aarya-tanwade/bone-buds/docs/README.md

# OSSIS / Documentation

Our engineering records for OSSIS, the first BoneBuds prototype.

| Document | Purpose |
| --- | --- |
| [Test setup](test-setup.md) | Shared bench wiring and firmware entry points |
| [Test results](test-results.md) | Passed tests and the latest playback check |
| [Development log](development-log.md) | Dated progress, earlier issues and changes |
| [Firmware guide](../code/README.md) | Build, upload and test instructions |

We have verified Bluetooth playback and wireless OTA. Our latest phone test uses two BCTs in parallel on one amplifier, with clear, loud audio. Independent stereo is next; CAD work continues in parallel.

The [root README](../README.md) gives the full project overview. Early baseline records used the name Alpha 0.1; we now call the prototype OSSIS. Older PNG diagrams under `images/diagrams/` remain historical references; our current wiring table and firmware guides describe the working setup.
