aarya-tanwade/bone-buds/images/README.md

# Images

Add prototype photos, wiring pictures, circuit diagrams, and test plots here as they become available.

Use descriptive filenames (for example, `prototype1-wiring.jpg`). The repository does not contain a verified wiring photograph yet.
