aarya-tanwade/bone-buds/hardware/compact_v2/exports/contact_detail.png

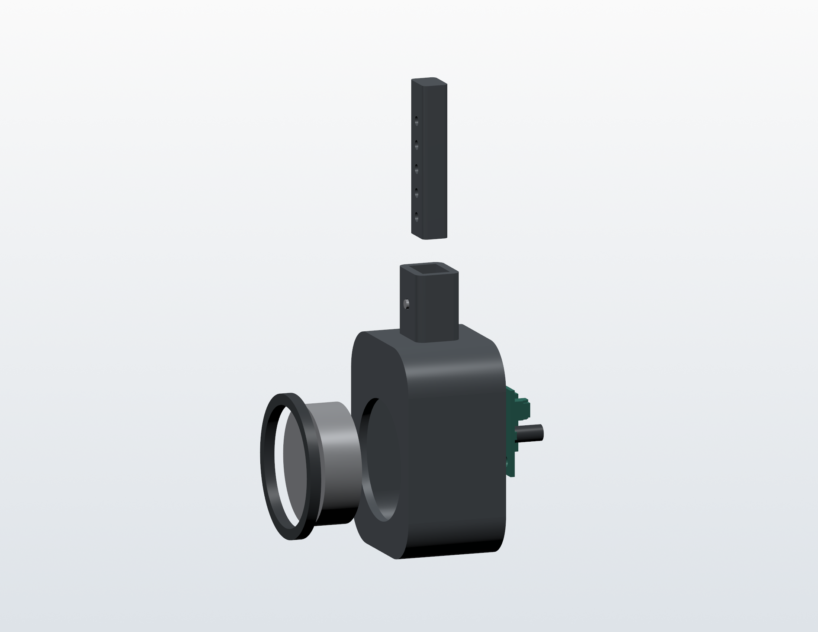
hardware/compact_v2/exports/contact_detail.png
