aarya-tanwade/bone-buds/hardware/compact_v2/exports/electronics.png

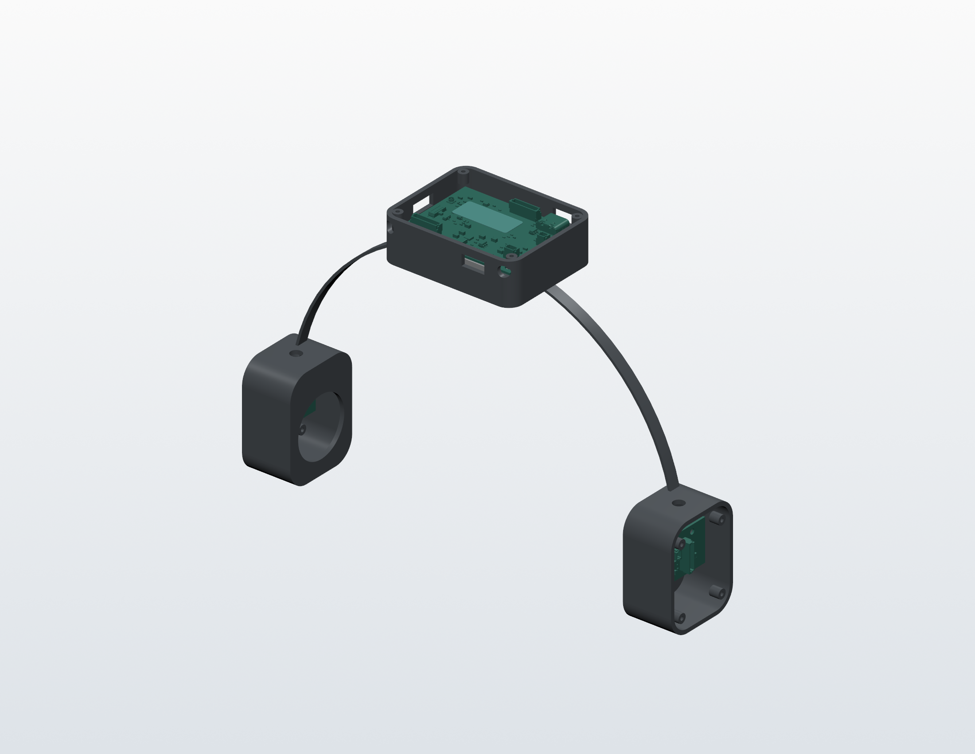
hardware/compact_v2/exports/electronics.png
