aarya-tanwade/bone-buds/hardware/compact_v2/exports/exploded.png

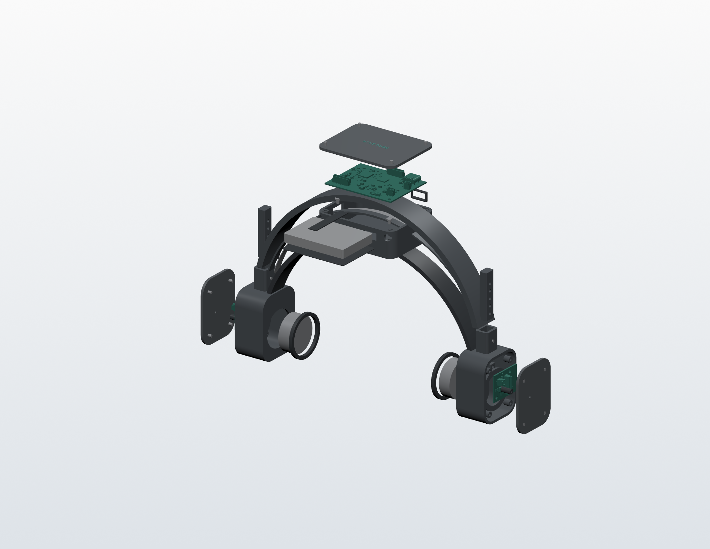
hardware/compact_v2/exports/exploded.png
