aarya-tanwade/bone-buds/hardware/compact_v2/exports/front.png

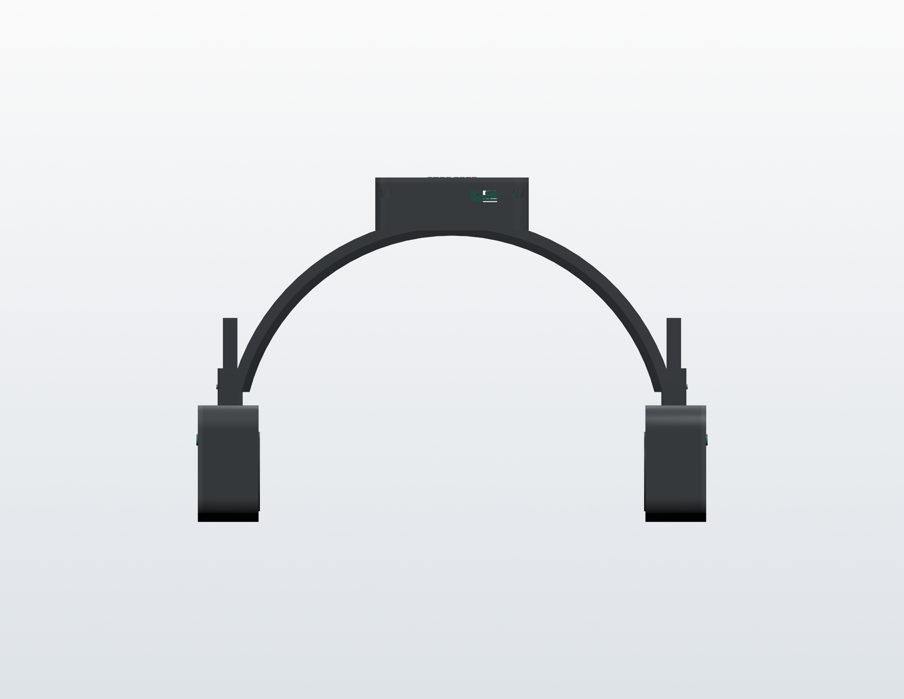
hardware/compact_v2/exports/front.png
