aarya-tanwade/bone-buds/hardware/compact_v2/exports/hero.png

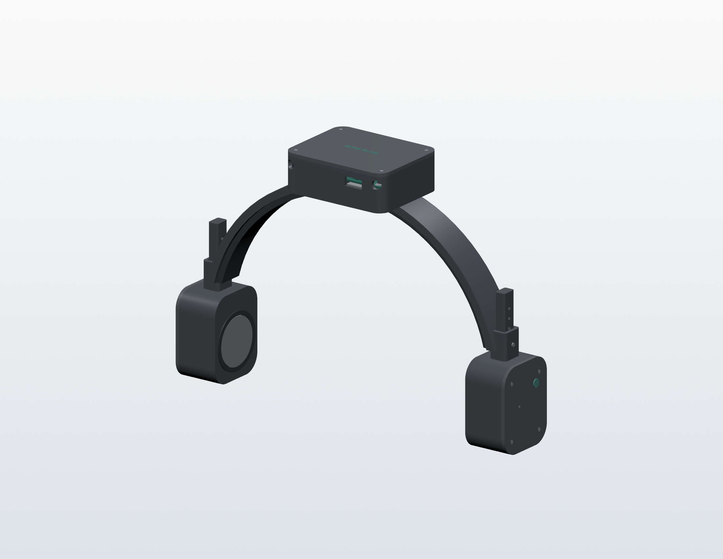
hardware/compact_v2/exports/hero.png
