aarya-tanwade/bone-buds/hardware/compact_v2/exports/side.png

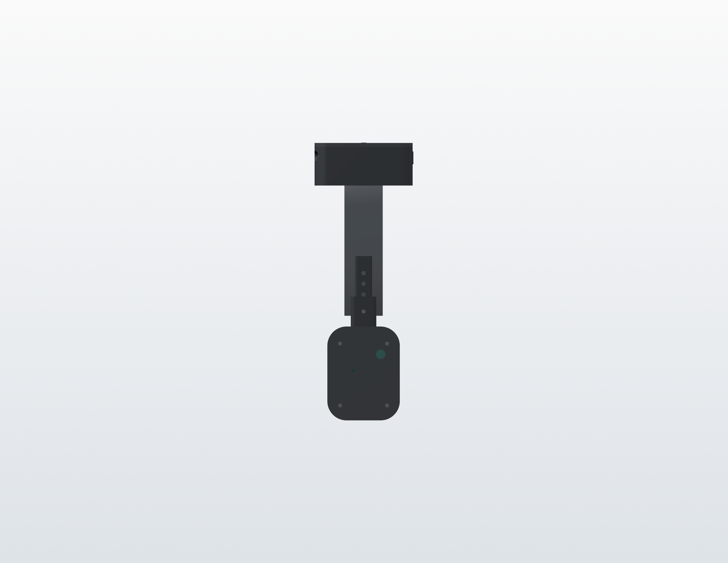
hardware/compact_v2/exports/side.png
