aarya-tanwade/bone-buds/hardware/compact_v2/exports/top.png

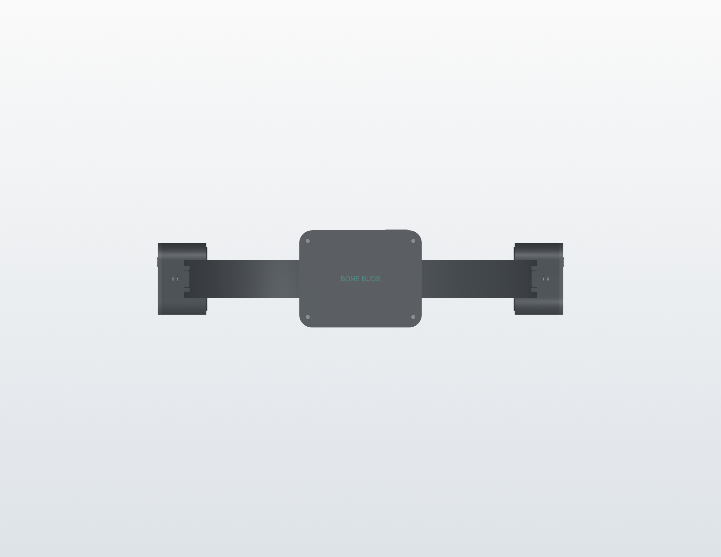
hardware/compact_v2/exports/top.png
