aarya-tanwade/bone-buds/hardware/compact_v2/sources/mic_drawing.png

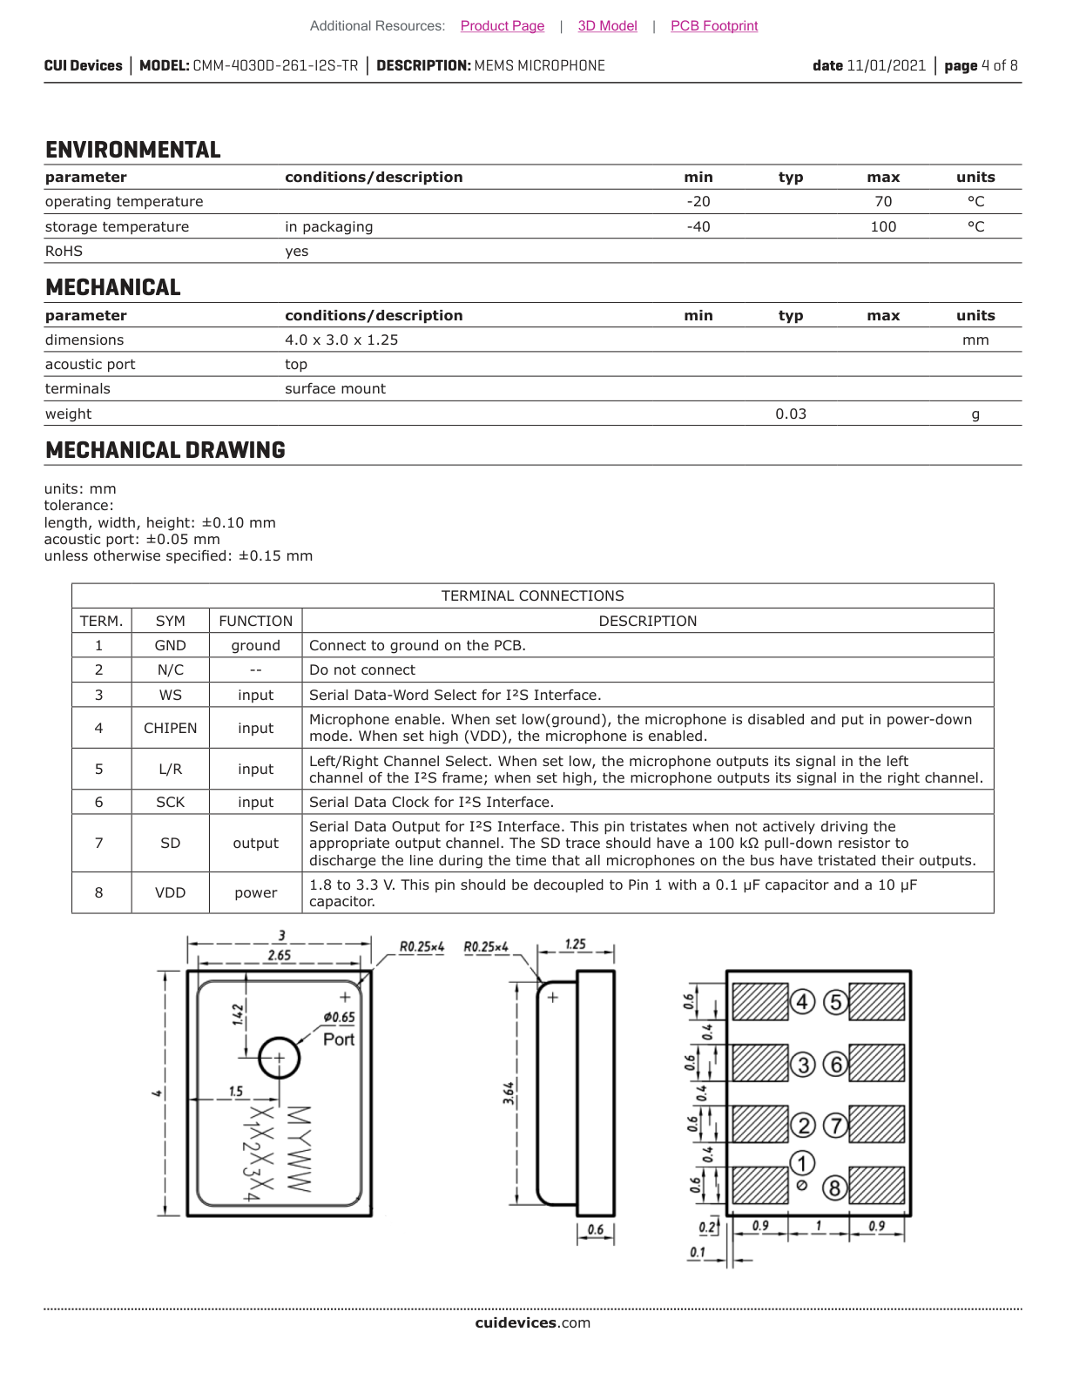
hardware/compact_v2/sources/mic_drawing.png
