aarya-tanwade/bone-buds/images/diagrams/current-audio-signal-flow.png

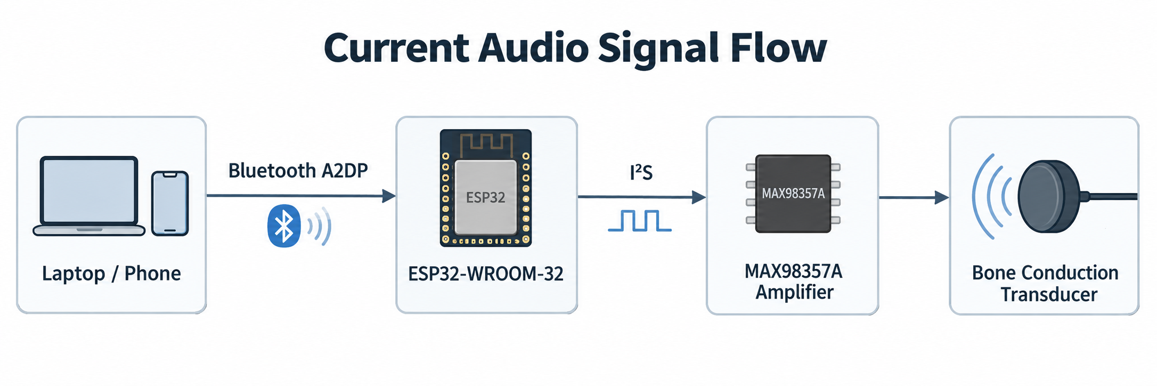
images/diagrams/current-audio-signal-flow.png
