aarya-tanwade/bone-buds/images/diagrams/development-progress.png

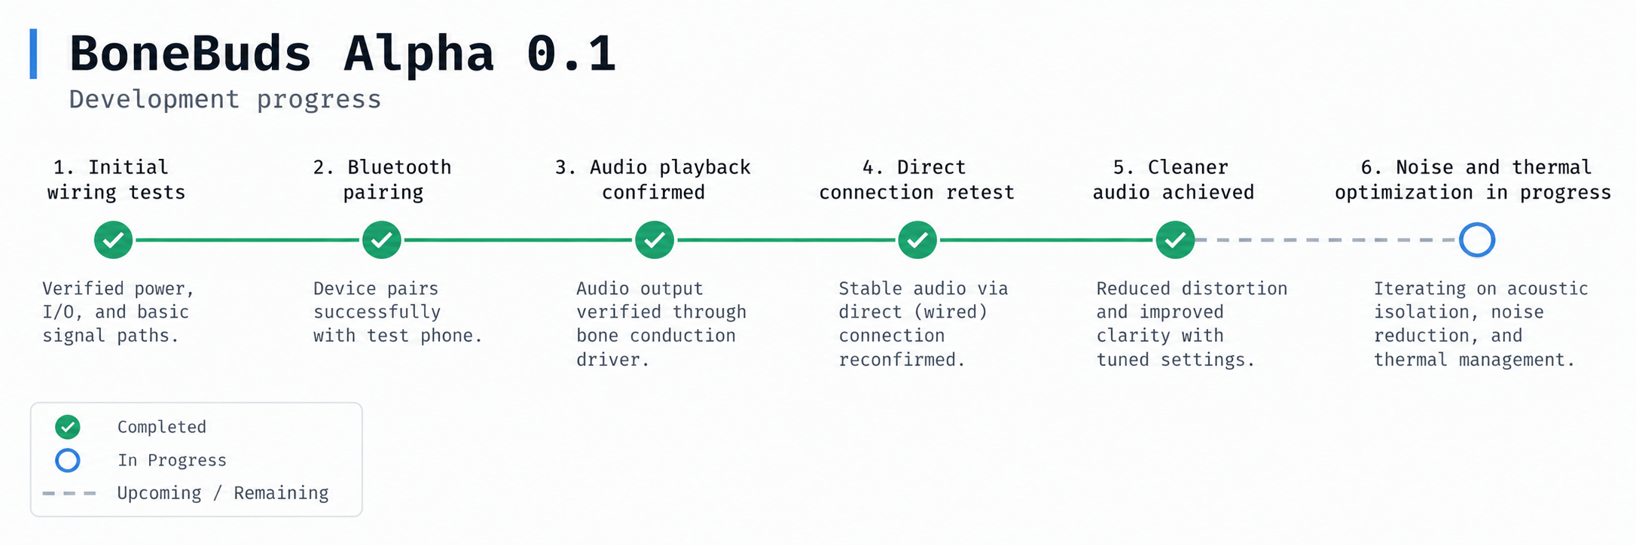
images/diagrams/development-progress.png
