aarya-tanwade/bone-buds/images/diagrams/ossis-stereo-audio-path.png

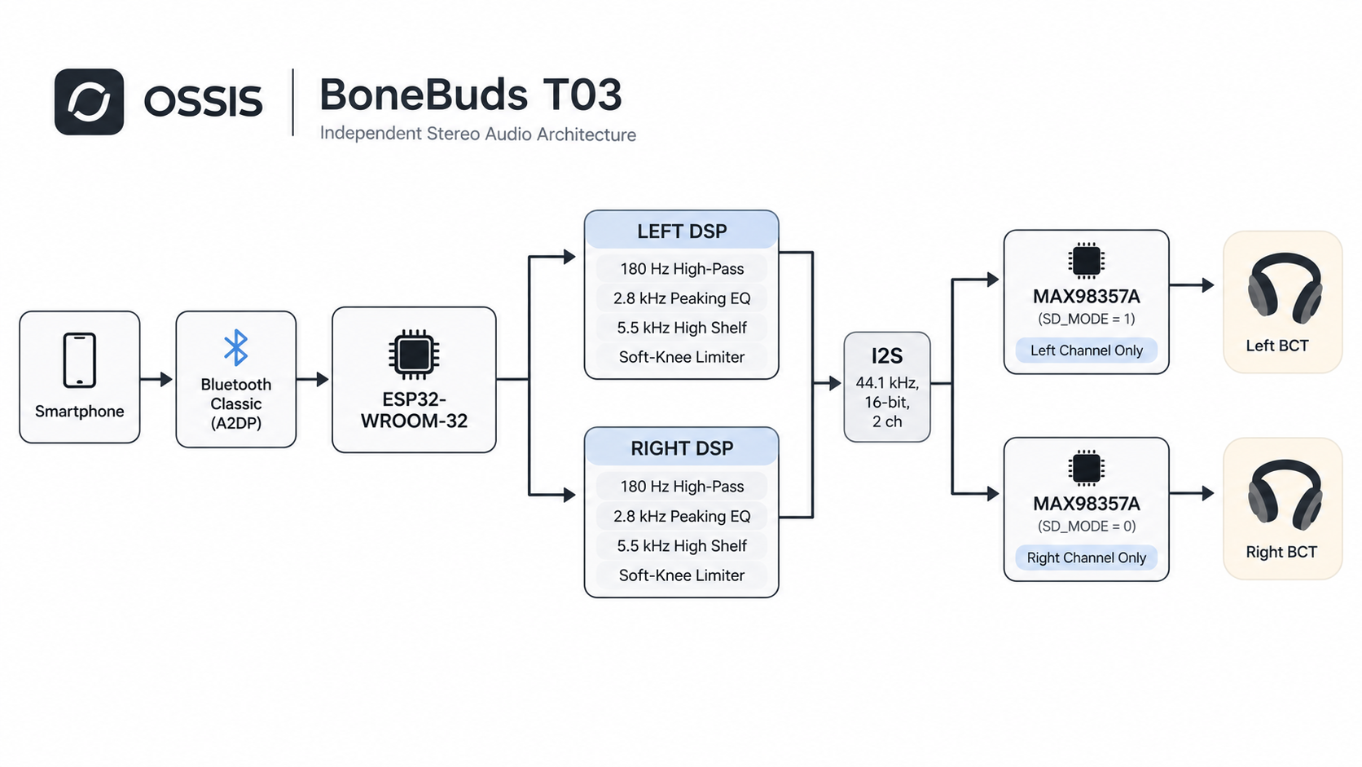
images/diagrams/ossis-stereo-audio-path.png
