aarya-tanwade/bone-buds/images/diagrams/t02-wireless-update.png

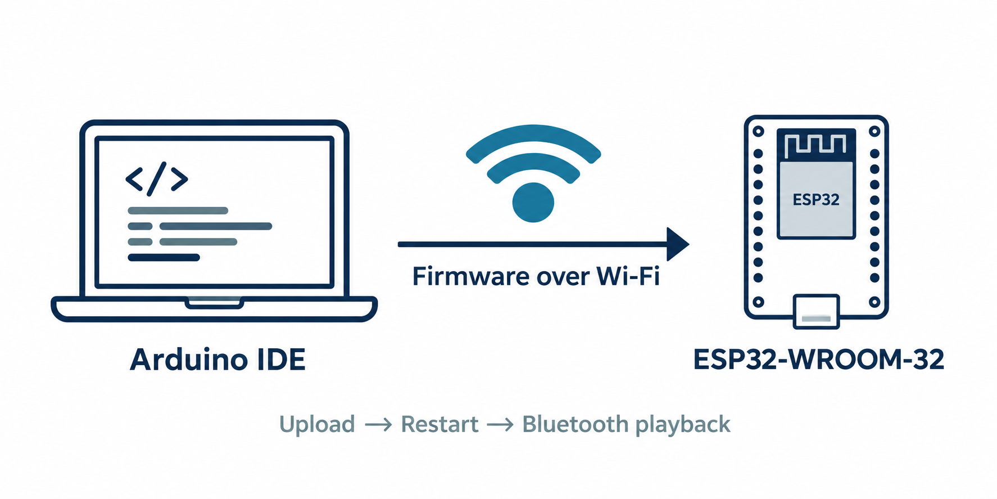
images/diagrams/t02-wireless-update.png
