aarya-tanwade/bone-buds/images/hero/bonebuds-alpha-0.1.png

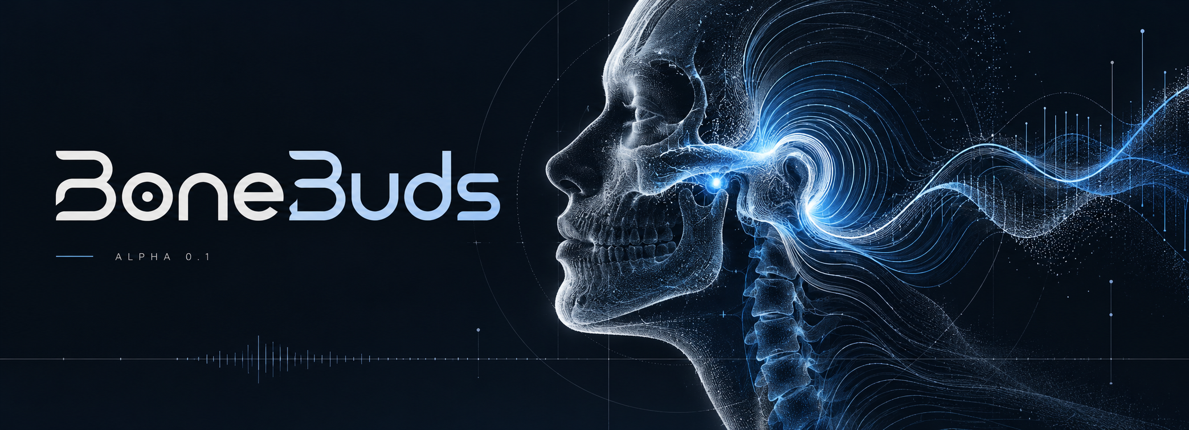
images/hero/bonebuds-alpha-0.1.png
