aarya-tanwade/bone-buds/hardware/compact_v2/mechanical/step/bone_buds_revb_assembly.step

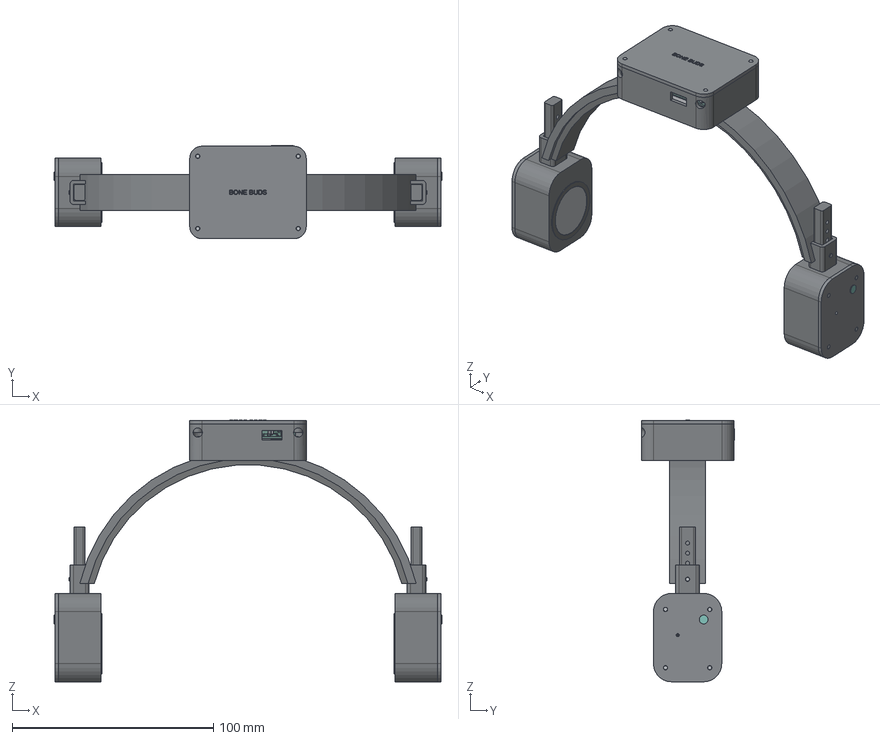
[picture p19: CAD file, 2026-10-23]
hardware/compact_v2/mechanical/step/bone_buds_revb_assembly.step
193.0 x 46.4 x 130.2 mm
01_PA12_headband_cable_channel
02_spring_strip_0p5mm
03_TPU_crown_cushion
04_hidden_loom_envelope
M2_PCB_screw_H1
M2_PCB_screw_H2
M2_lid_screw_-25_-18
M2_lid_screw_25_-18
M2_lid_screw_-25_18
M2_lid_screw_25_18
05_PA12_controller_lower_shell
06_PA12_controller_service_lid
07_ACTUAL_KICAD_CONTROLLER
08_PROTECTED_1S_500mAh_PACK_ENVELOPE
09_TPU_battery_cradle
10_TPU_battery_retaining_strap
11_recessed_brand_mark
12_FPC_ANTENNA_ENVELOPE
13_USB_port_TPU_bezel
right_M2_service_screw_-11_-22
right_M2_service_screw_11_-22
right_M2_service_screw_-11_7
right_M2_service_screw_11_7
right_PA12_pod_shell
right_PA12_service_lid
right_ACTUAL_KICAD_AUDIO
right_TRANSDUCER_25x8_ENVELOPE
right_PA12_rigid_transducer_retainer
right_TPU_skin_contact_surround
right_TPU_mic_acoustic_duct
right_TPU_cable_strain_relief
right_PA12_adjustment_rail
right_PA12_slide_collar
right_M2_fit_clamp
right_TPU_tactile_LR_marker
left_M2_service_screw_-11_-22
left_M2_service_screw_11_-22
left_M2_service_screw_-11_7
left_M2_service_screw_11_7
left_PA12_pod_shell
left_PA12_service_lid
left_ACTUAL_KICAD_AUDIO
left_TRANSDUCER_25x8_ENVELOPE
left_PA12_rigid_transducer_retainer
left_TPU_skin_contact_surround
left_TPU_mic_acoustic_duct
left_TPU_cable_strain_relief
left_PA12_adjustment_rail
left_PA12_slide_collar
left_M2_fit_clamp
left_TPU_tactile_LR_marker
