aarya-tanwade/bone-buds/hardware/compact_v2/mechanical/step/left_PA12_slide_collar.step

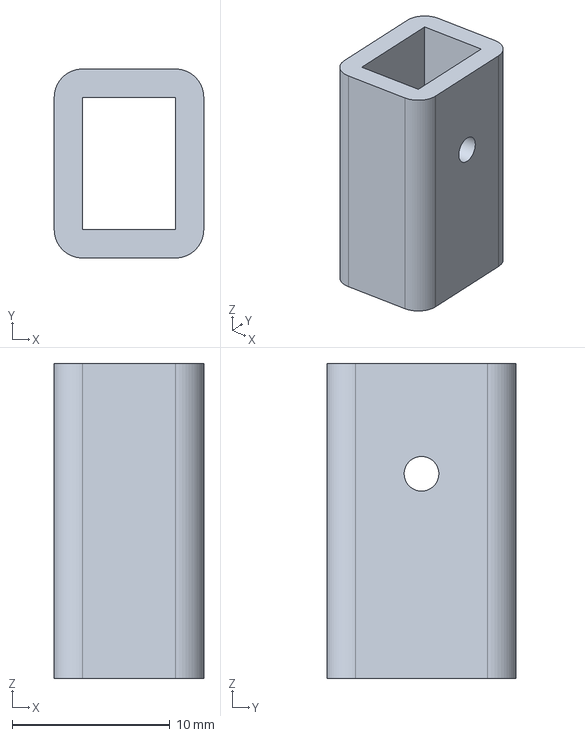
[picture p20: CAD file, 2026-10-23]
hardware/compact_v2/mechanical/step/left_PA12_slide_collar.step
9.50 x 12.0 x 20.0 mm
