aarya-tanwade/bone-buds/hardware/compact_v2/mechanical/step/left_PA12_rigid_transducer_retainer.step

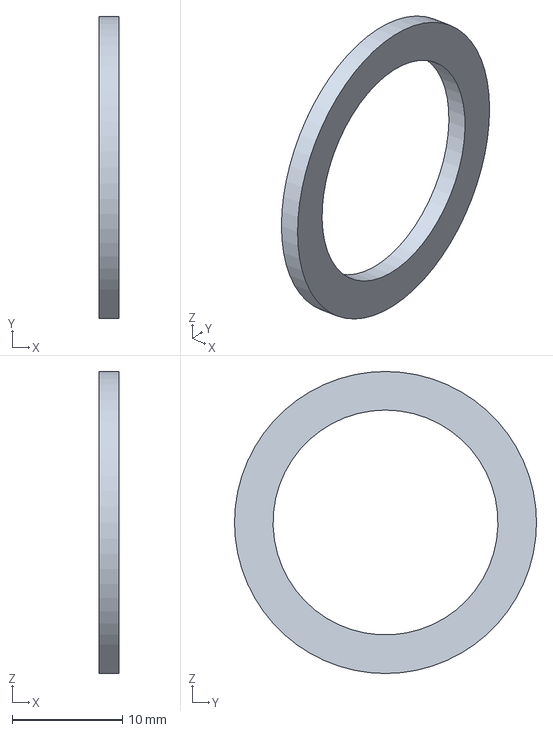
[picture p21: CAD file, 2026-10-23]
hardware/compact_v2/mechanical/step/left_PA12_rigid_transducer_retainer.step
1.80 x 27.4 x 27.4 mm
