aarya-tanwade/bone-buds/hardware/compact_v2/pcb/models/CMM4030.step

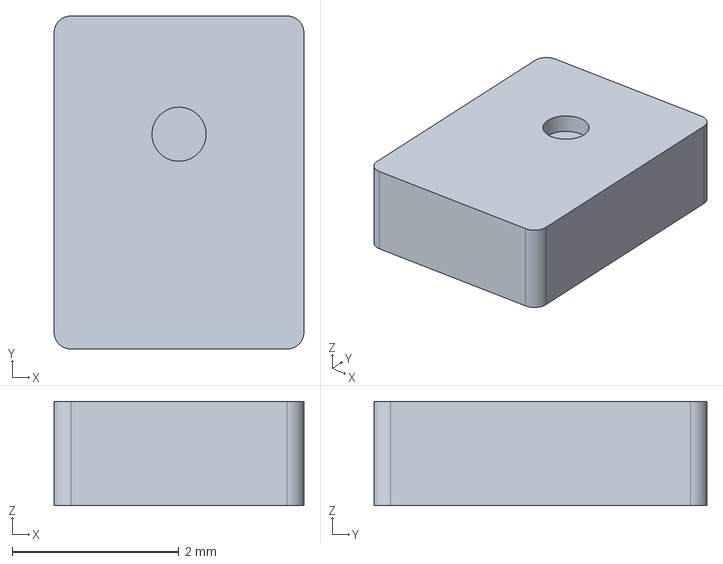
[picture p22: CAD file, 2026-10-23]
hardware/compact_v2/pcb/models/CMM4030.step
3.00 x 4.00 x 1.25 mm
