aarya-tanwade/bone-buds/hardware/compact_v2/mechanical/step/06_PA12_controller_service_lid.step

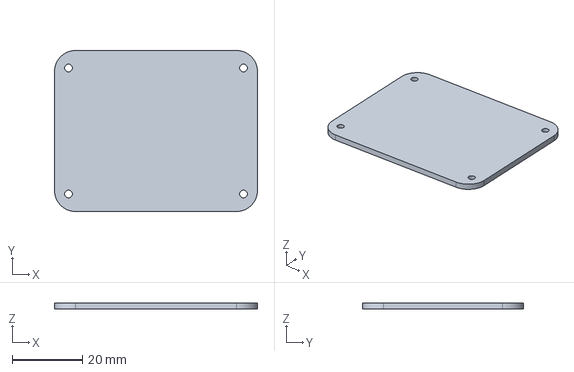
[picture p23: CAD file, 2026-10-23]
hardware/compact_v2/mechanical/step/06_PA12_controller_service_lid.step
58.0 x 46.0 x 1.80 mm
