aarya-tanwade/bone-buds/hardware/compact_v2/mechanical/step/05_PA12_controller_lower_shell.step

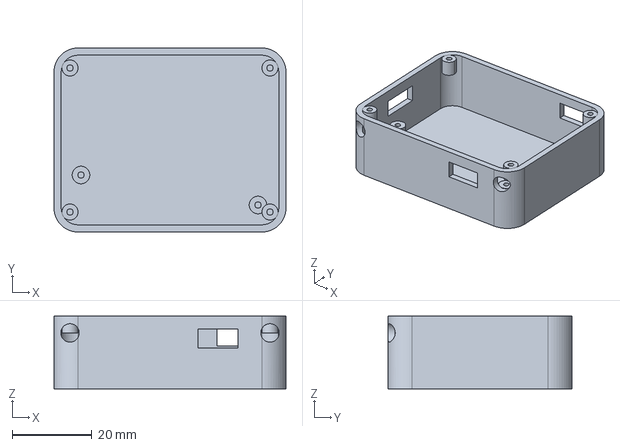
[picture p24: CAD file, 2026-10-23]
hardware/compact_v2/mechanical/step/05_PA12_controller_lower_shell.step
58.0 x 46.0 x 18.2 mm
