aarya-tanwade/bone-buds/hardware/compact_v2/mechanical/step/left_TPU_mic_acoustic_duct.step

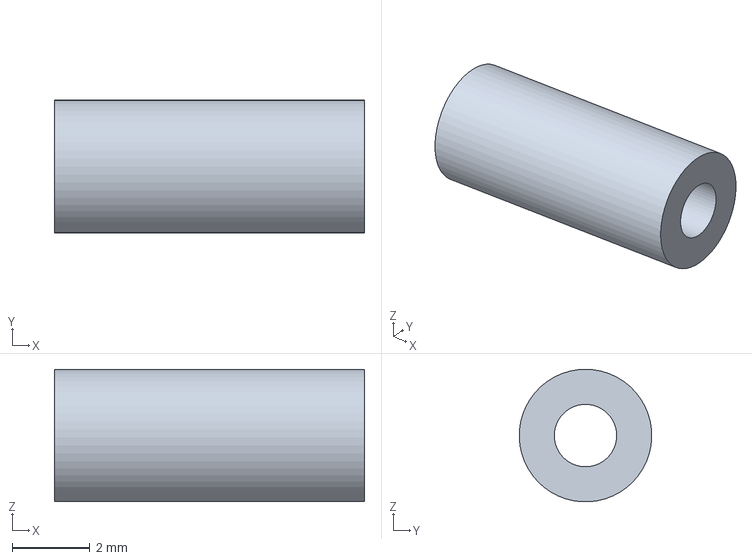
[picture p25: CAD file, 2026-10-23]
hardware/compact_v2/mechanical/step/left_TPU_mic_acoustic_duct.step
7.95 x 3.40 x 3.40 mm
