aarya-tanwade/bone-buds/hardware/compact_v2/mechanical/step/01_PA12_headband_cable_channel.step

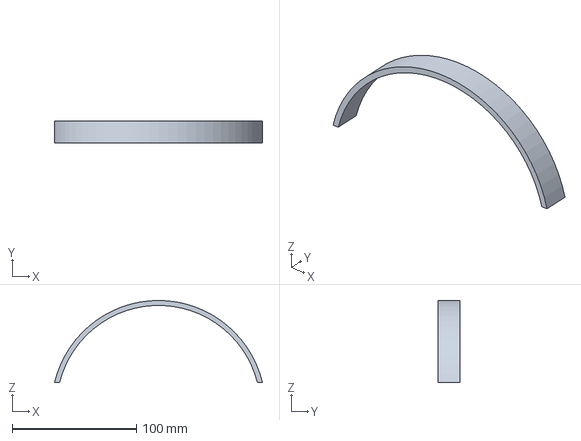
[picture p26: CAD file, 2026-10-23]
hardware/compact_v2/mechanical/step/01_PA12_headband_cable_channel.step
167.3 x 18.0 x 66.0 mm
