aarya-tanwade/bone-buds/hardware/compact_v2/mechanical/step/left_PA12_pod_shell.step

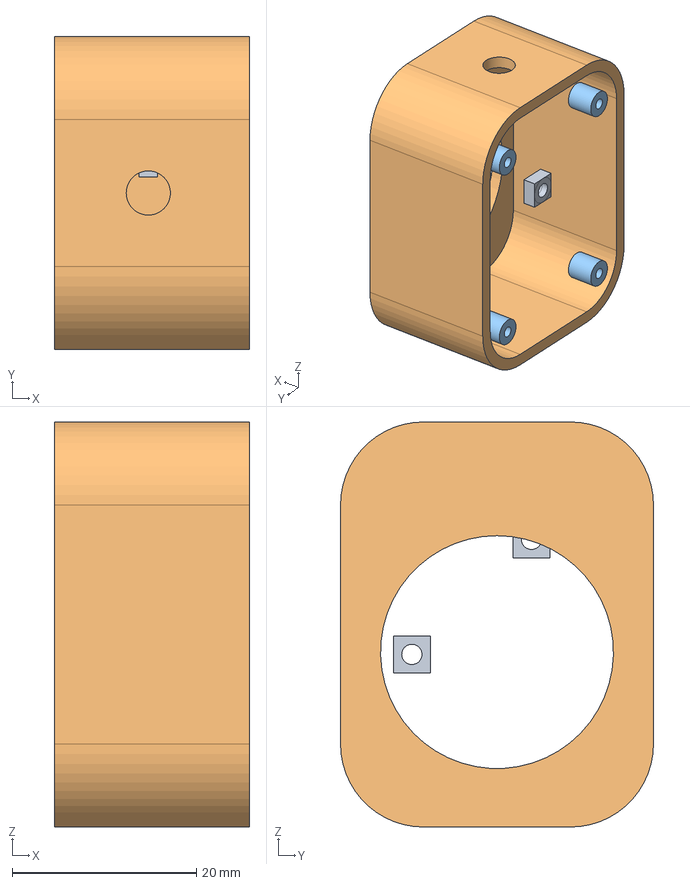
[picture p27: CAD file, 2026-10-23]
hardware/compact_v2/mechanical/step/left_PA12_pod_shell.step
21.2 x 34.0 x 44.0 mm
