aarya-tanwade/bone-buds/hardware/compact_v2/mechanical/step/09_TPU_battery_cradle.step

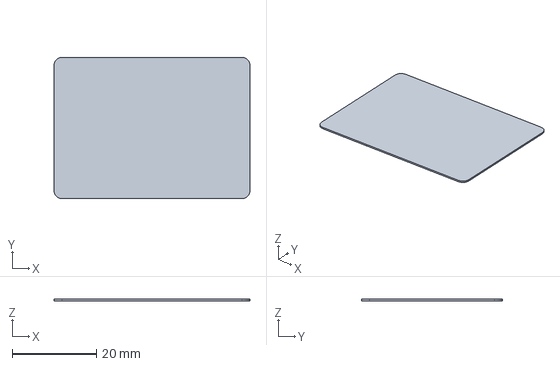
[picture p28: CAD file, 2026-10-23]
hardware/compact_v2/mechanical/step/09_TPU_battery_cradle.step
46.6 x 33.6 x 0.4 mm
