aarya-tanwade/bone-buds/hardware/compact_v2/mechanical/step/right_TPU_cable_strain_relief.step

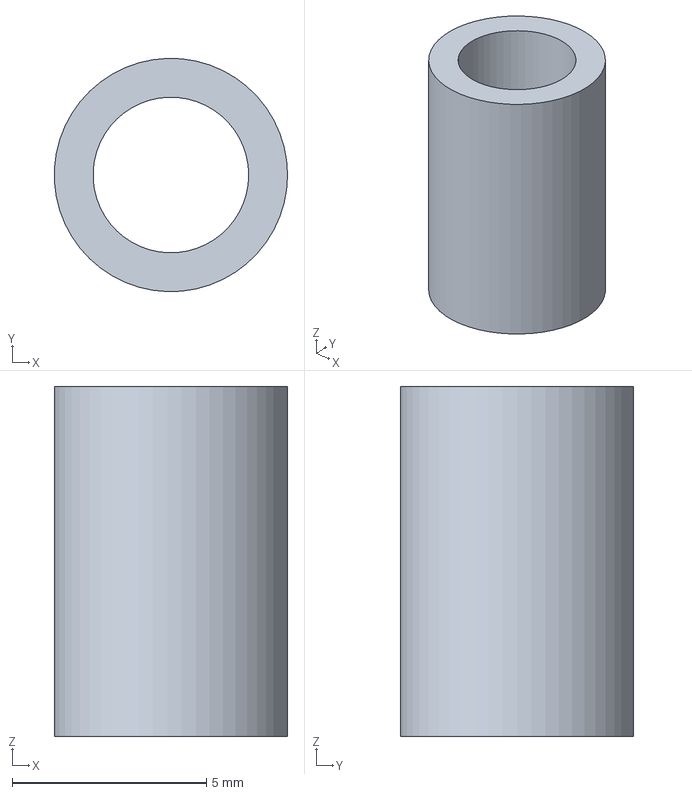
[picture p29: CAD file, 2026-10-23]
hardware/compact_v2/mechanical/step/right_TPU_cable_strain_relief.step
5.99 x 6.00 x 9.00 mm
