aarya-tanwade/bone-buds/hardware/compact_v2/mechanical/step/audio_left.step

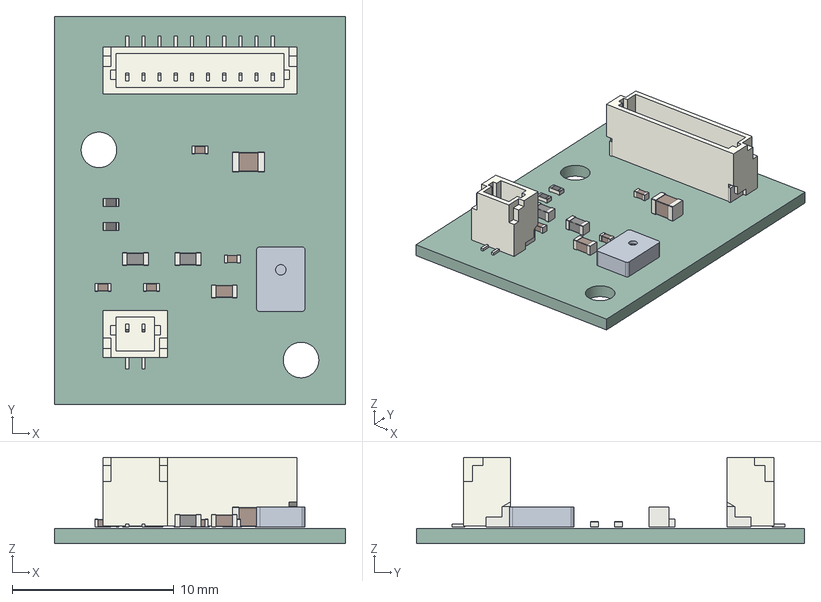
[picture p30: CAD file, 2026-10-23]
hardware/compact_v2/mechanical/step/audio_left.step
18.0 x 24.0 x 5.33 mm
L_0603_1608Metric x 2
C_0805_2012Metric
C_0402_1005Metric x 4
C_0603_1608Metric
R_0402_1005Metric x 2
JST_SH_BM10B-SRSS-TB_1x10-1MP_P1.00mm_Vertical
JST_SH_BM02B-SRSS-TB_1x02-1MP_P1.00mm_Vertical
audio_left_PCB
