aarya-tanwade/bone-buds/hardware/compact_v2/mechanical/step/right_PA12_adjustment_rail.step

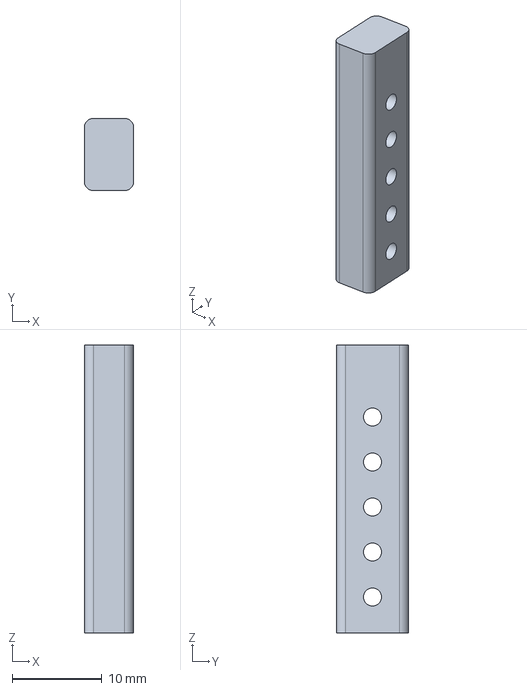
[picture p31: CAD file, 2026-10-23]
hardware/compact_v2/mechanical/step/right_PA12_adjustment_rail.step
5.50 x 8.00 x 32.0 mm
