aarya-tanwade/bone-buds/hardware/compact_v2/mechanical/step/right_PA12_service_lid.step

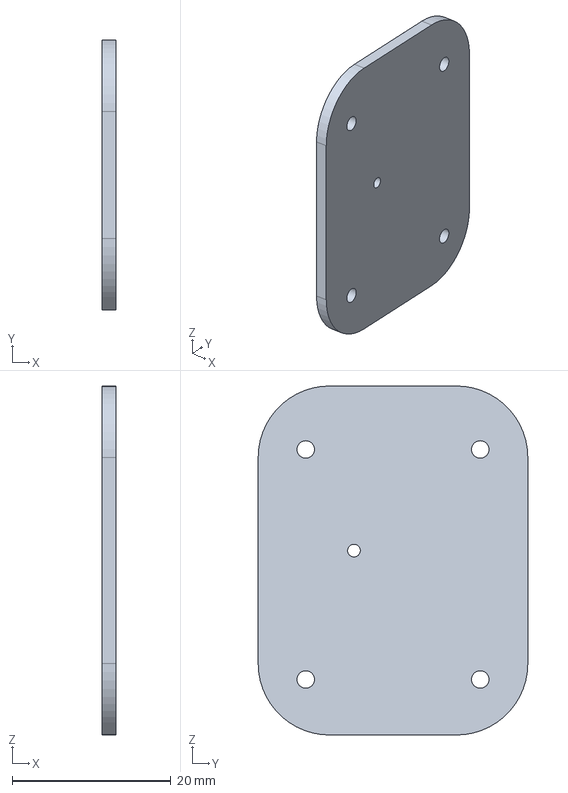
[picture p32: CAD file, 2026-10-23]
hardware/compact_v2/mechanical/step/right_PA12_service_lid.step
1.80 x 34.0 x 44.0 mm
