aarya-tanwade/bone-buds/hardware/compact_v2/mechanical/step/right_TPU_skin_contact_surround.step

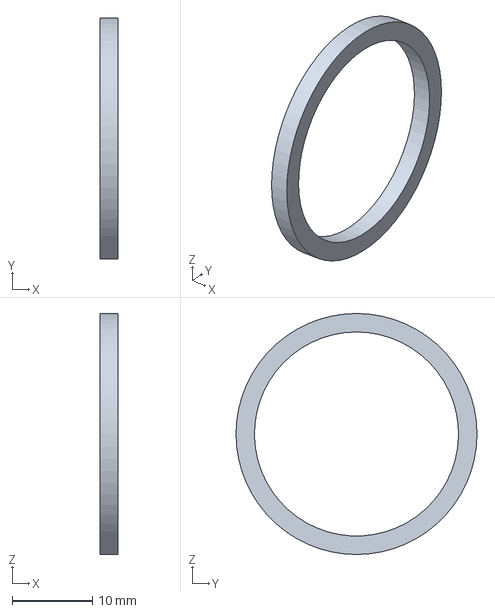
[picture p33: CAD file, 2026-10-23]
hardware/compact_v2/mechanical/step/right_TPU_skin_contact_surround.step
2.30 x 30.0 x 30.0 mm
