aarya-tanwade/bone-buds/hardware/compact_v2/mechanical/step/03_TPU_crown_cushion.step

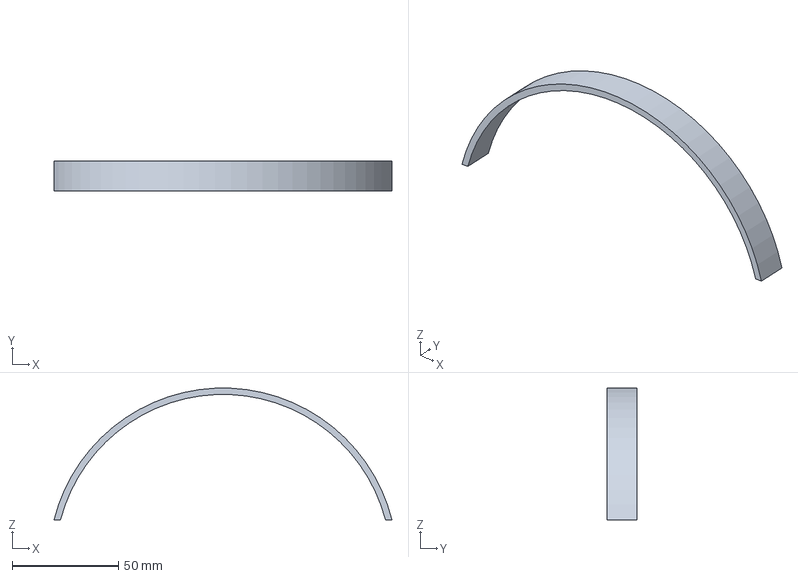
[picture p34: CAD file, 2026-10-23]
hardware/compact_v2/mechanical/step/03_TPU_crown_cushion.step
159.0 x 14.0 x 61.9 mm
