aarya-tanwade/bone-buds/hardware/compact_v2/mechanical/step/controller.step

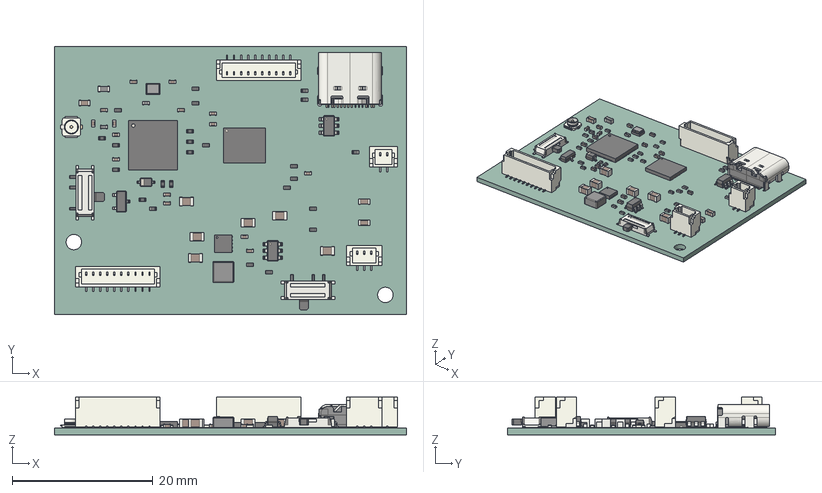
[picture p35: CAD file, 2026-10-23]
hardware/compact_v2/mechanical/step/controller.step
50.0 x 38.0 x 5.33 mm
R_0402_1005Metric x 24
C_0402_1005Metric x 15
L_0402_1005Metric x 2
C_0805_2012Metric x 6
C_0603_1608Metric x 3
L_Wuerth_MAPI_3015
D_SOD-323
JST_SH_BM10B-SRSS-TB_1x10-1MP_P1.00mm_Vertical x 2
JST_SH_BM02B-SRSS-TB_1x02-1MP_P1.00mm_Vertical
WSON-8-1EP_6x5mm_P1.27mm_EP3.4x4.3mm
7a0a93aa-926b-11ed-8620-a0cec80452fd_part
7a0a9878-926b-11ed-8620-a0cec80452fd_part
7a0a9b48-926b-11ed-8620-a0cec80452fd_part
7a0a9db4-926b-11ed-8620-a0cec80452fd_part
SOT-23-6 x 2
Fusion_sp x 2
SOT-23
U.FL_Hirose_U.FL-R-SMT-1_Vertical
USB_C_Receptacle_16P_TopMnt_Horizontal_GCT_USB4105-xx-A
JST_SH_BM03B-SRSS-TB_1x03-1MP_P1.00mm_Vertical
L_0603_1608Metric
a48c614c-8773-11ed-8f9d-58fb8493fcfb_part
a48c63fe-8773-11ed-8f9d-58fb8493fcfb_part
a48c65a2-8773-11ed-8f9d-58fb8493fcfb_part
a48c66d8-8773-11ed-8f9d-58fb8493fcfb_part
Crystal_SMD_2016-4Pin_2.0x1.6mm
controller_PCB
