aarya-tanwade/bone-buds/hardware/compact_v2/mechanical/step/10_TPU_battery_retaining_strap.step

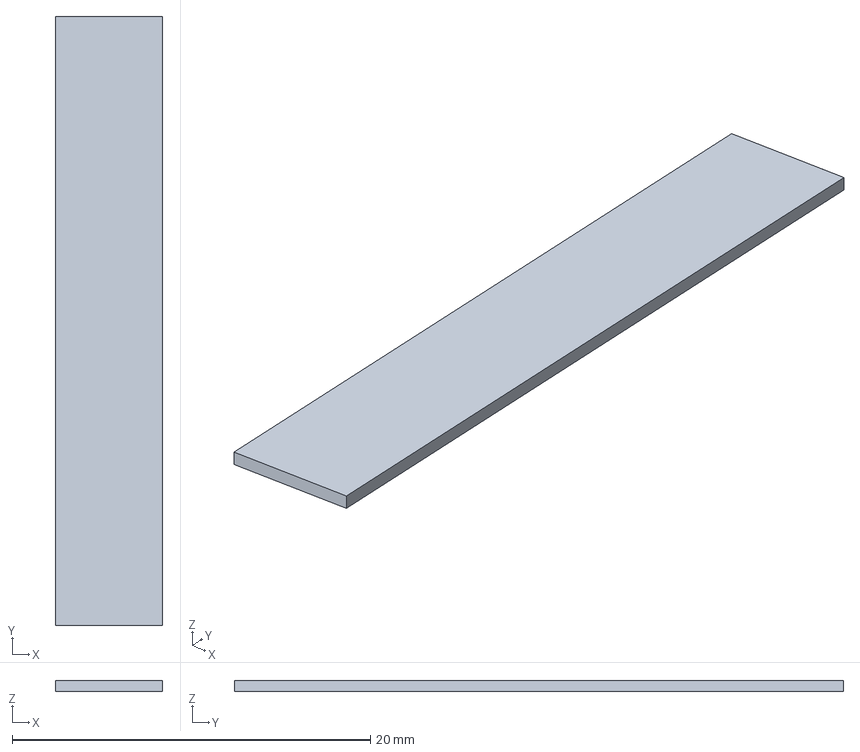
[picture p36: CAD file, 2026-10-23]
hardware/compact_v2/mechanical/step/10_TPU_battery_retaining_strap.step
6.00 x 34.0 x 0.6 mm
