aarya-tanwade/bone-buds/hardware/compact_v2/mechanical/step/13_USB_port_TPU_bezel.step

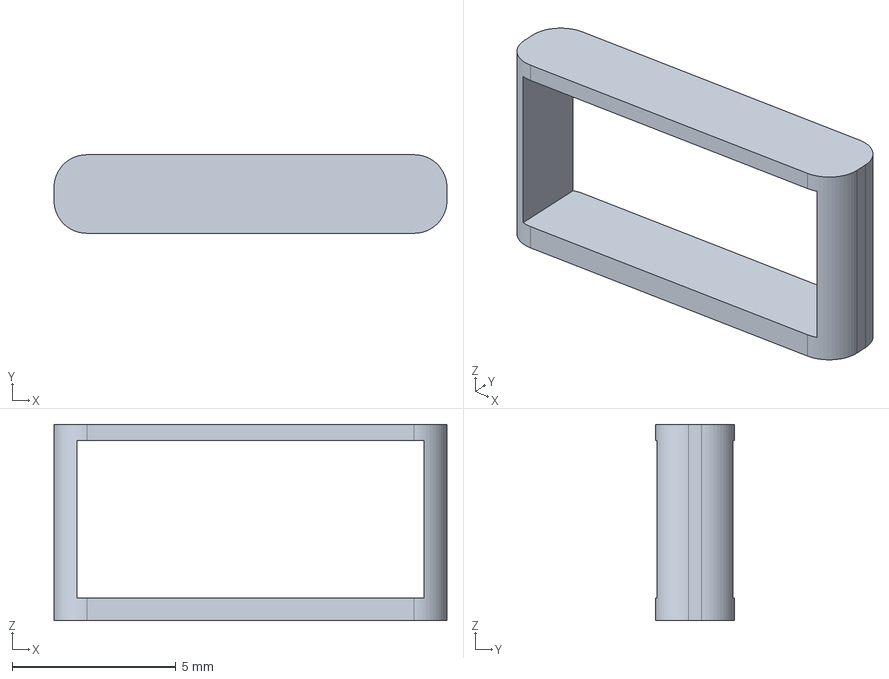
[picture p37: CAD file, 2026-10-23]
hardware/compact_v2/mechanical/step/13_USB_port_TPU_bezel.step
12.0 x 2.40 x 6.00 mm
