aarya-tanwade/bone-buds/(list of files, cad)

Other CAD files:
hardware/compact_v2/mechanical/step/left_PA12_adjustment_rail.step
hardware/compact_v2/mechanical/step/left_PA12_service_lid.step
hardware/compact_v2/mechanical/step/right_PA12_slide_collar.step
hardware/compact_v2/mechanical/step/right_TPU_mic_acoustic_duct.step
hardware/compact_v2/mechanical/step/left_TPU_skin_contact_surround.step
hardware/compact_v2/mechanical/step/left_TPU_cable_strain_relief.step
hardware/compact_v2/mechanical/step/right_PA12_pod_shell.step
hardware/compact_v2/mechanical/step/audio_right.step
hardware/compact_v2/mechanical/step/right_PA12_rigid_transducer_retainer.step
hardware/compact_v2/mechanical/stl/01_PA12_headband_cable_channel.stl
hardware/compact_v2/mechanical/stl/03_TPU_crown_cushion.stl
hardware/compact_v2/mechanical/stl/05_PA12_controller_lower_shell.stl
hardware/compact_v2/mechanical/stl/06_PA12_controller_service_lid.stl
hardware/compact_v2/mechanical/stl/09_TPU_battery_cradle.stl
hardware/compact_v2/mechanical/stl/10_TPU_battery_retaining_strap.stl
hardware/compact_v2/mechanical/stl/13_USB_port_TPU_bezel.stl
hardware/compact_v2/mechanical/stl/left_PA12_adjustment_rail.stl
hardware/compact_v2/mechanical/stl/left_PA12_pod_shell.stl
hardware/compact_v2/mechanical/stl/left_PA12_rigid_transducer_retainer.stl
hardware/compact_v2/mechanical/stl/left_PA12_service_lid.stl
hardware/compact_v2/mechanical/stl/left_PA12_slide_collar.stl
hardware/compact_v2/mechanical/stl/left_TPU_cable_strain_relief.stl
hardware/compact_v2/mechanical/stl/left_TPU_mic_acoustic_duct.stl
hardware/compact_v2/mechanical/stl/left_TPU_skin_contact_surround.stl
hardware/compact_v2/mechanical/stl/right_PA12_adjustment_rail.stl
hardware/compact_v2/mechanical/stl/right_PA12_pod_shell.stl
hardware/compact_v2/mechanical/stl/right_PA12_rigid_transducer_retainer.stl
hardware/compact_v2/mechanical/stl/right_PA12_service_lid.stl
hardware/compact_v2/mechanical/stl/right_PA12_slide_collar.stl
hardware/compact_v2/mechanical/stl/right_TPU_cable_strain_relief.stl
hardware/compact_v2/mechanical/stl/right_TPU_mic_acoustic_duct.stl
hardware/compact_v2/mechanical/stl/right_TPU_skin_contact_surround.stl
hardware/compact_v2/pcb/models/BQ24074_VQFN16.step
hardware/compact_v2/pcb/models/MAX98357A_TQFN16.step
