aarya-tanwade/bone-buds/images/diagrams/current-test-setup.png

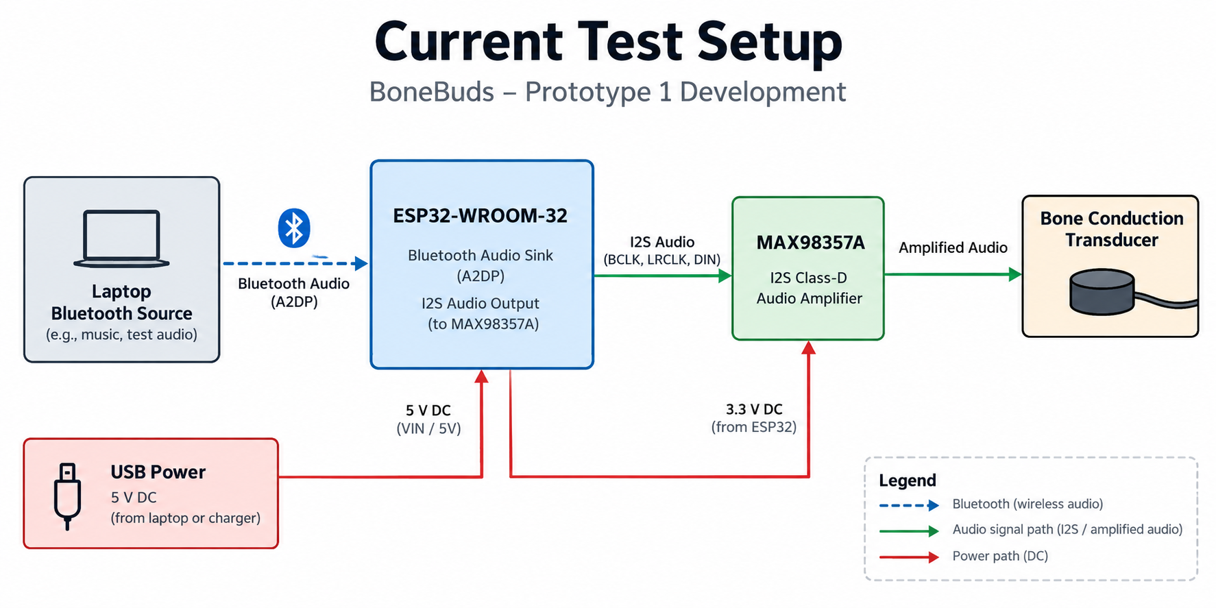
images/diagrams/current-test-setup.png
