aarya-tanwade/bone-buds/images/tests/T01/t01-youtube-thumbnail.jpg

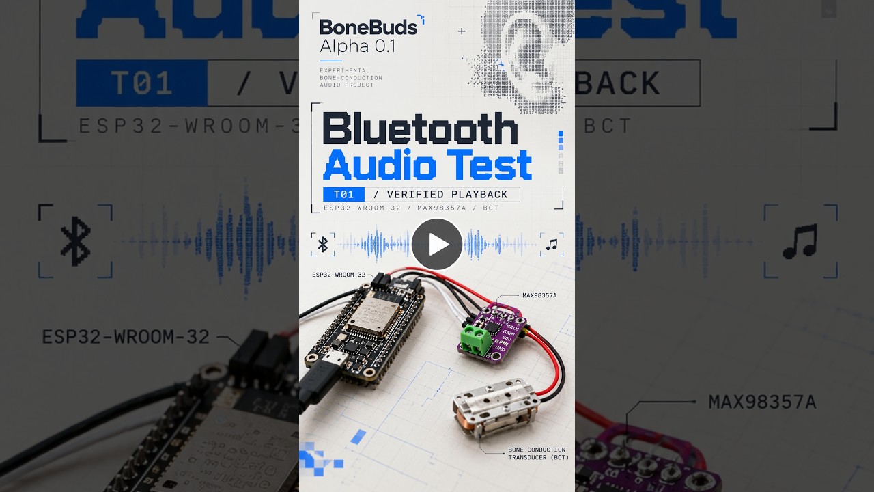
images/tests/T01/t01-youtube-thumbnail.jpg
