aarya-tanwade/bone-buds/hardware/compact_v2/exports/audio_left_schematic.pdf

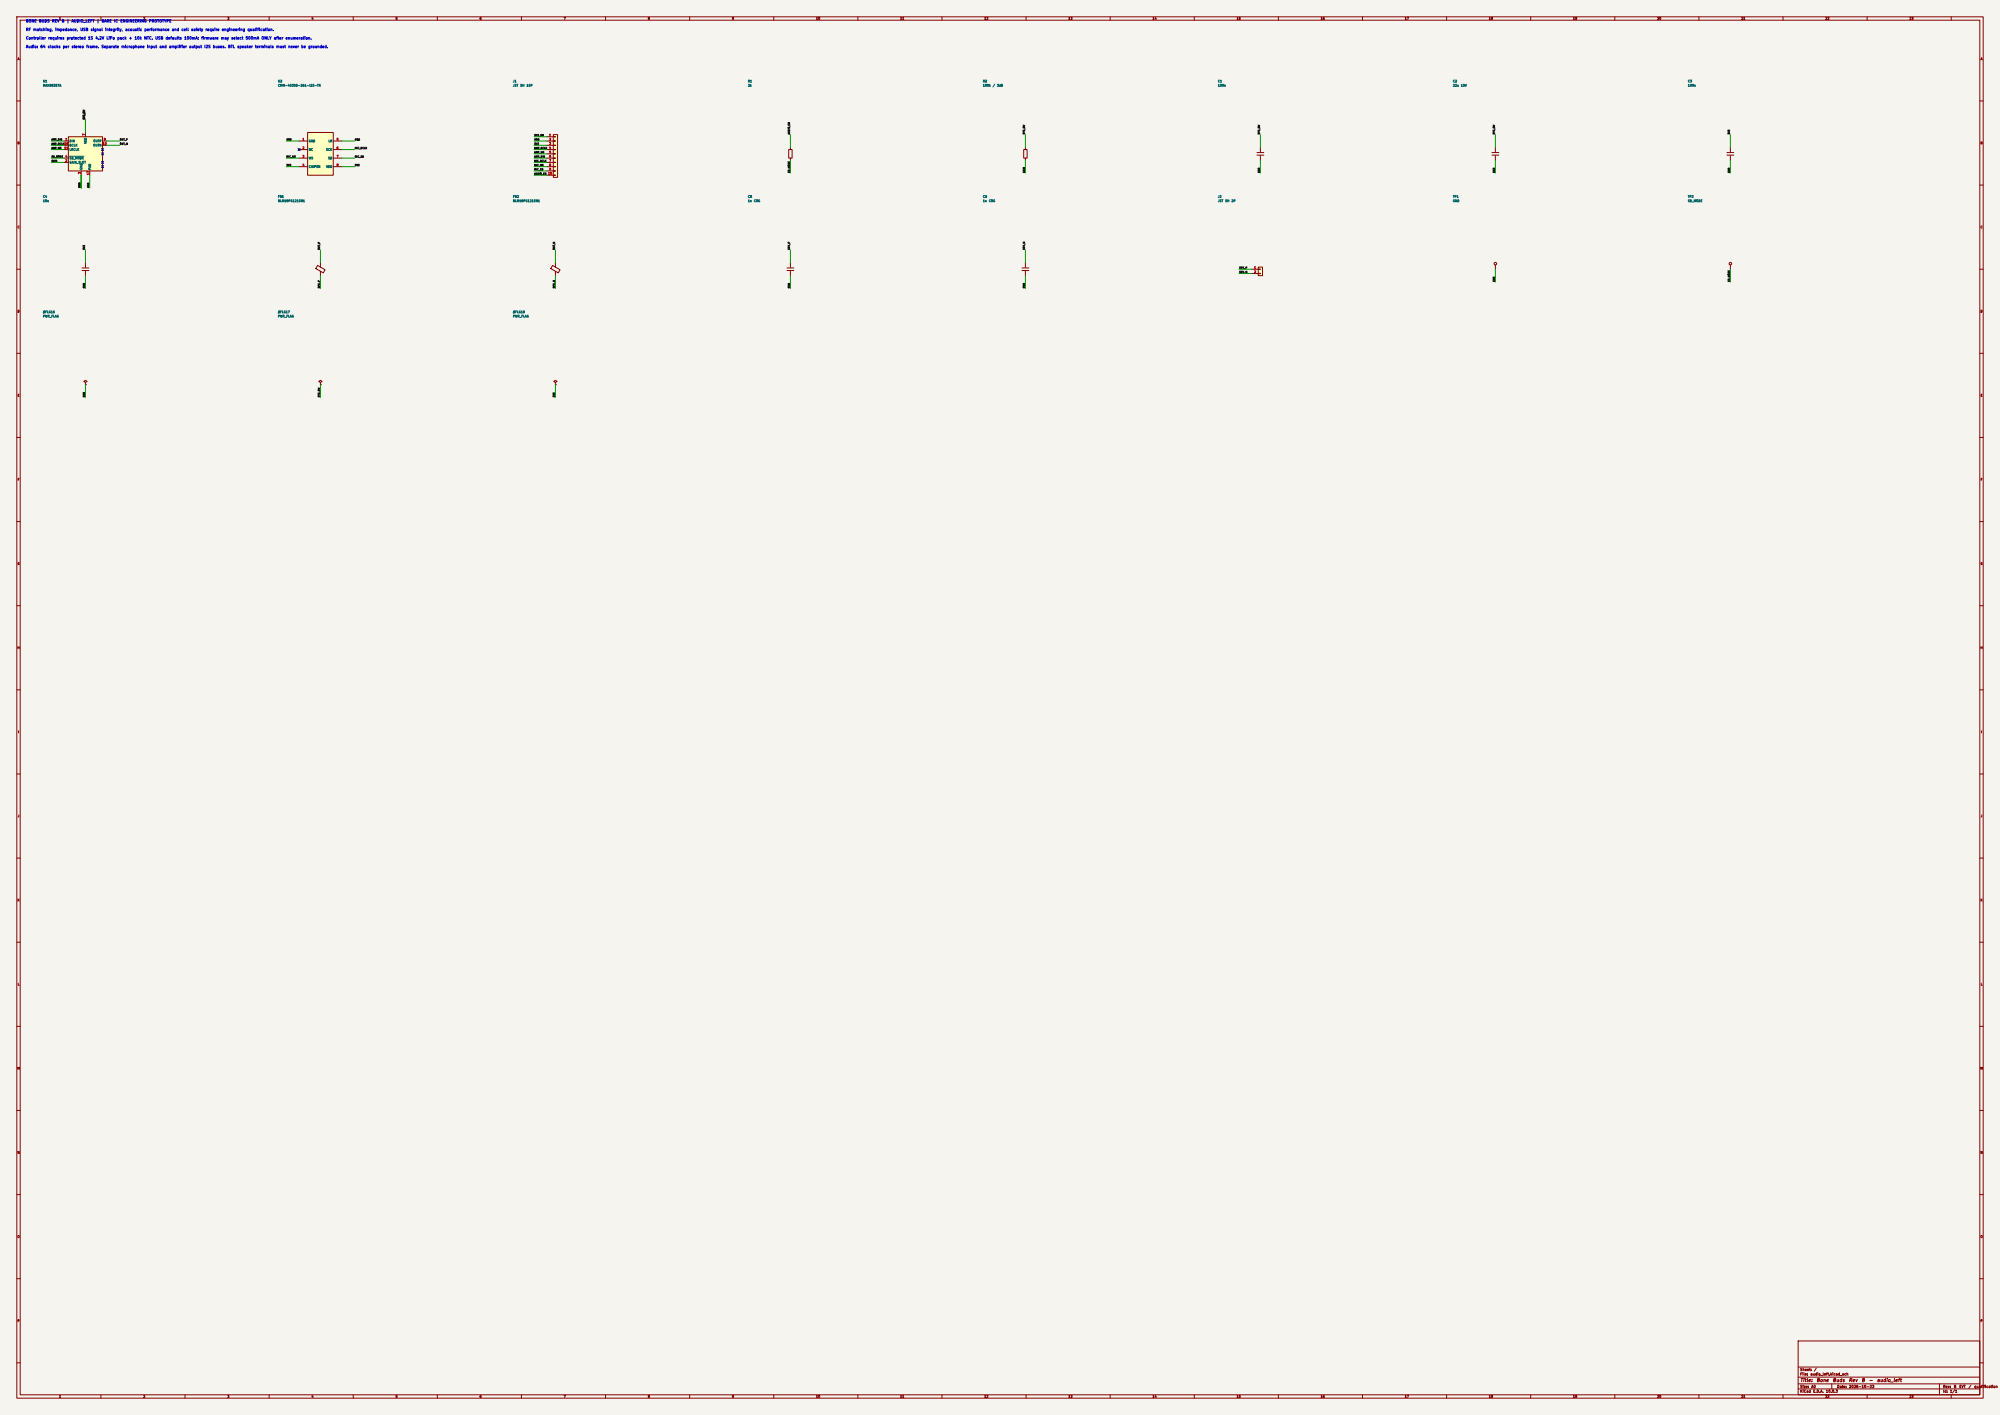
[picture p40: page 1]

AMP_WS MIC_BCLK BONE BUDS REV B | AUDIO_LEFT | BARE IC ENGINEERING PROTOTYPE

RF matching, impedance, USB signal integrity, acoustic performance and cell safety require engineering qualification.

Controller requires protected 1S 4.2V LiPo pack + 10k NTC. USB defaults 100mA; firmware may select 500mA ONLY after enumeration.

Audio: 64 clocks per stereo frame. Separate microphone input and amplifier output I2S buses. BTL speaker terminals must never be grounded.
