aarya-tanwade/bone-buds/hardware/compact_v2/exports/controller_schematic.pdf

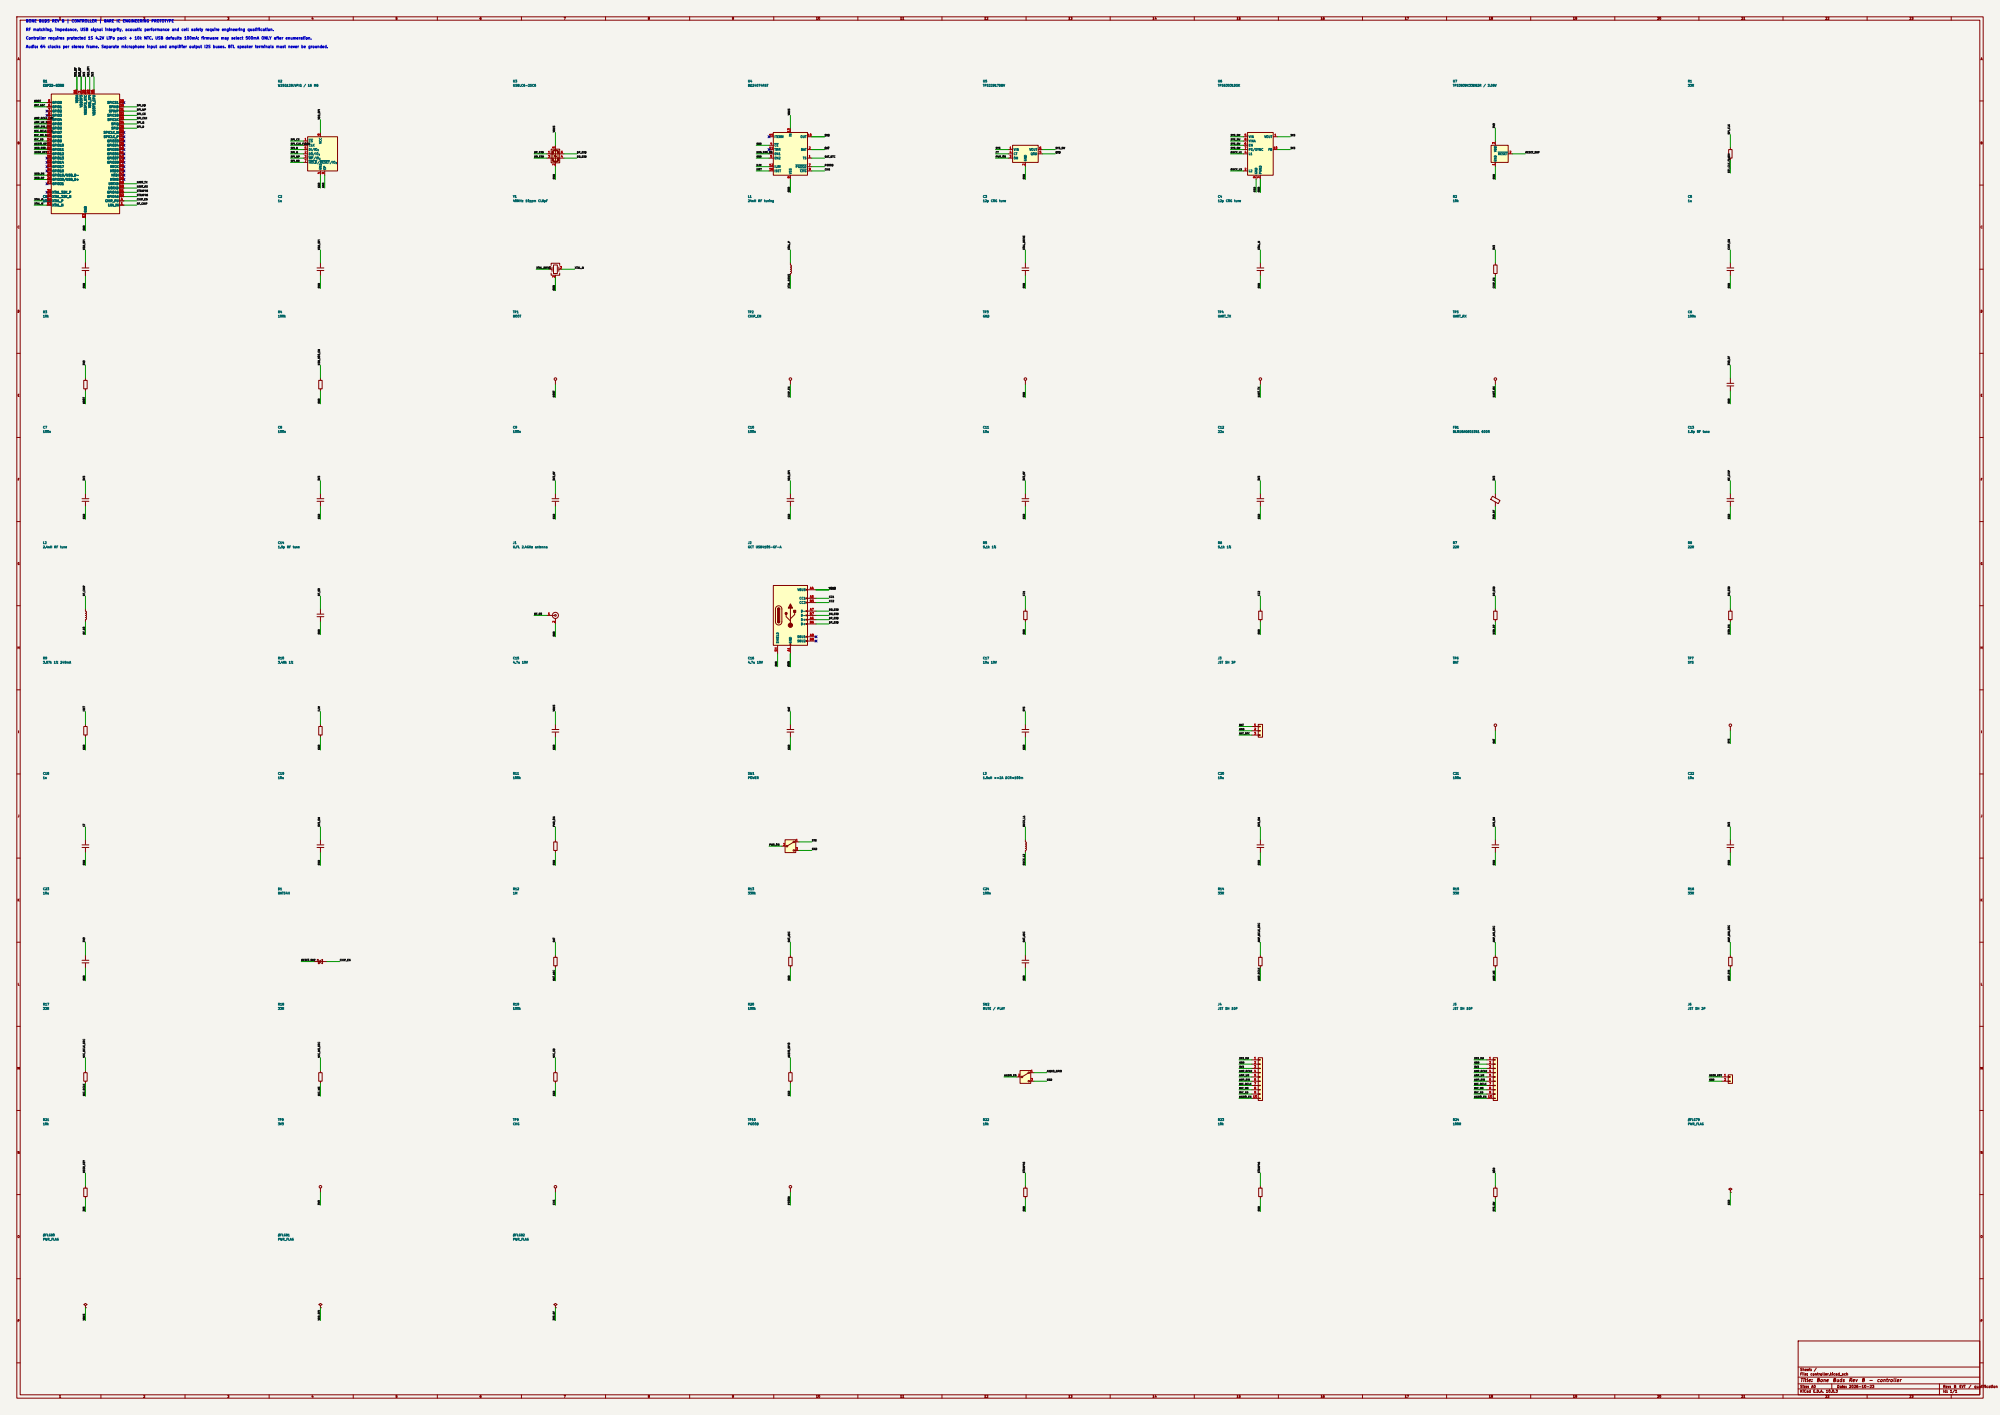
[picture p41: page 1]

BONE BUDS REV B | CONTROLLER | BARE IC ENGINEERING PROTOTYPE
SPICLK_N 36 MTDO 45 GPIO45 51

RF matching, impedance, USB signal integrity, acoustic performance and cell safety require engineering qualification.

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

Audio: 64 clocks per stereo frame. Separate microphone input and amplifier output I2S buses. BTL speaker terminals must never be grounded. C1

4 DI/IO0 5 CLK 6 HOLD/RESET/IO3 7 VCC

Sheet: /
File: controller.kicad_sch
Title: Bone Buds Rev B - controller
KiCad E.D.A. 10.0.3
