aarya-tanwade/bone-buds/hardware/compact_v2/pcb/audio_left/audio_left.kicad_pcb

## KiCad design hardware/compact_v2/pcb/audio_left/audio_left.kicad_pcb (2026-10-23)

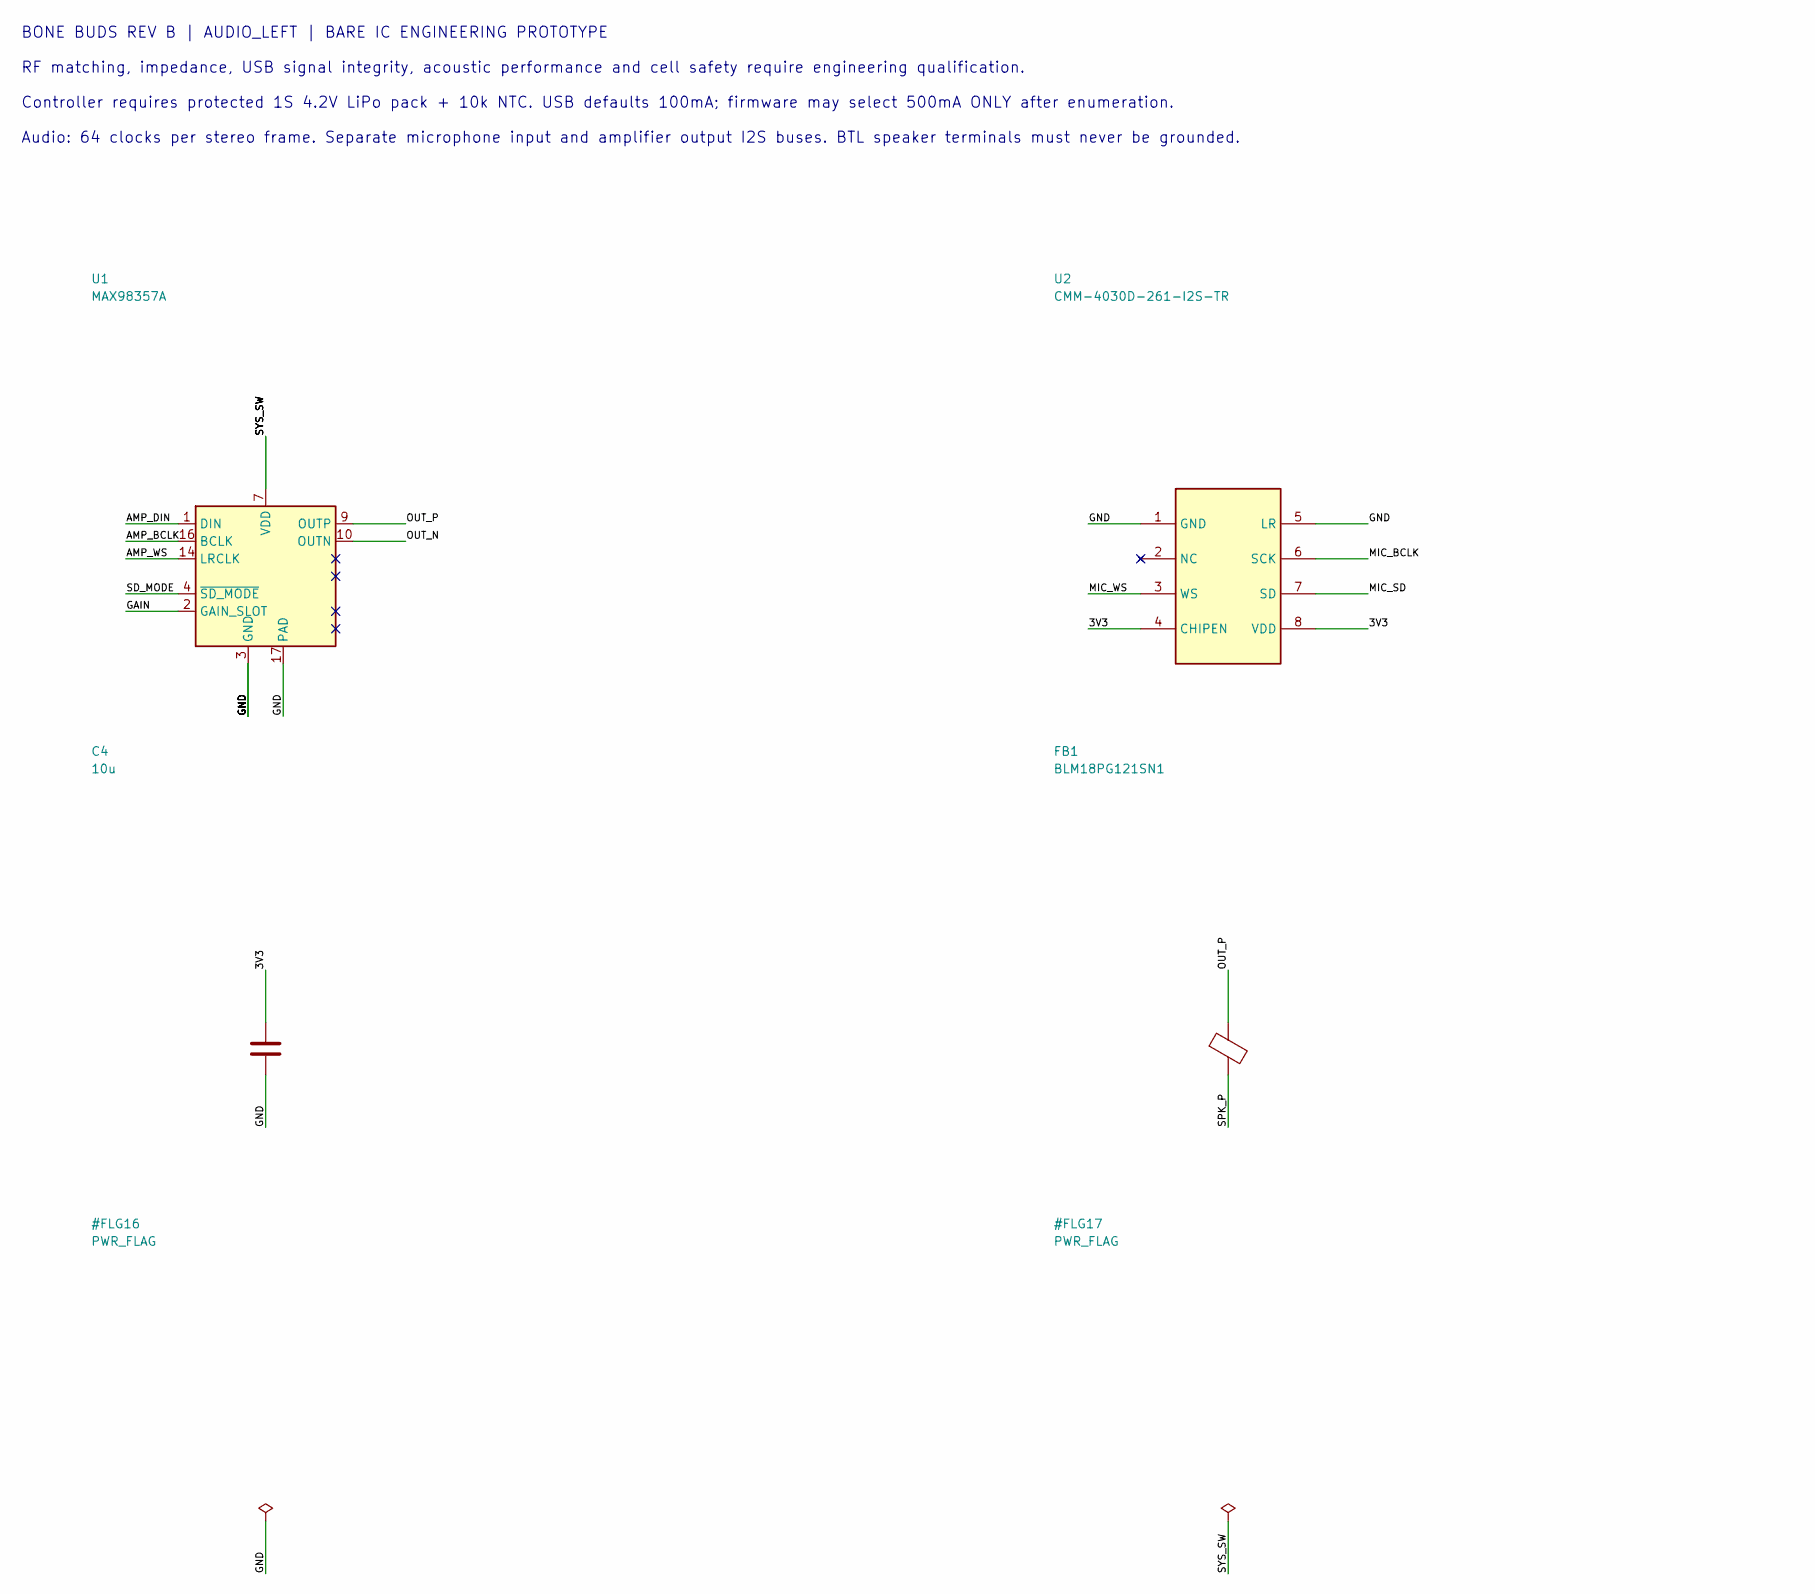
[picture p42: schematic audio_left.kicad_sch, Bone Buds Rev B - audio_left, part in row 1, column 1]

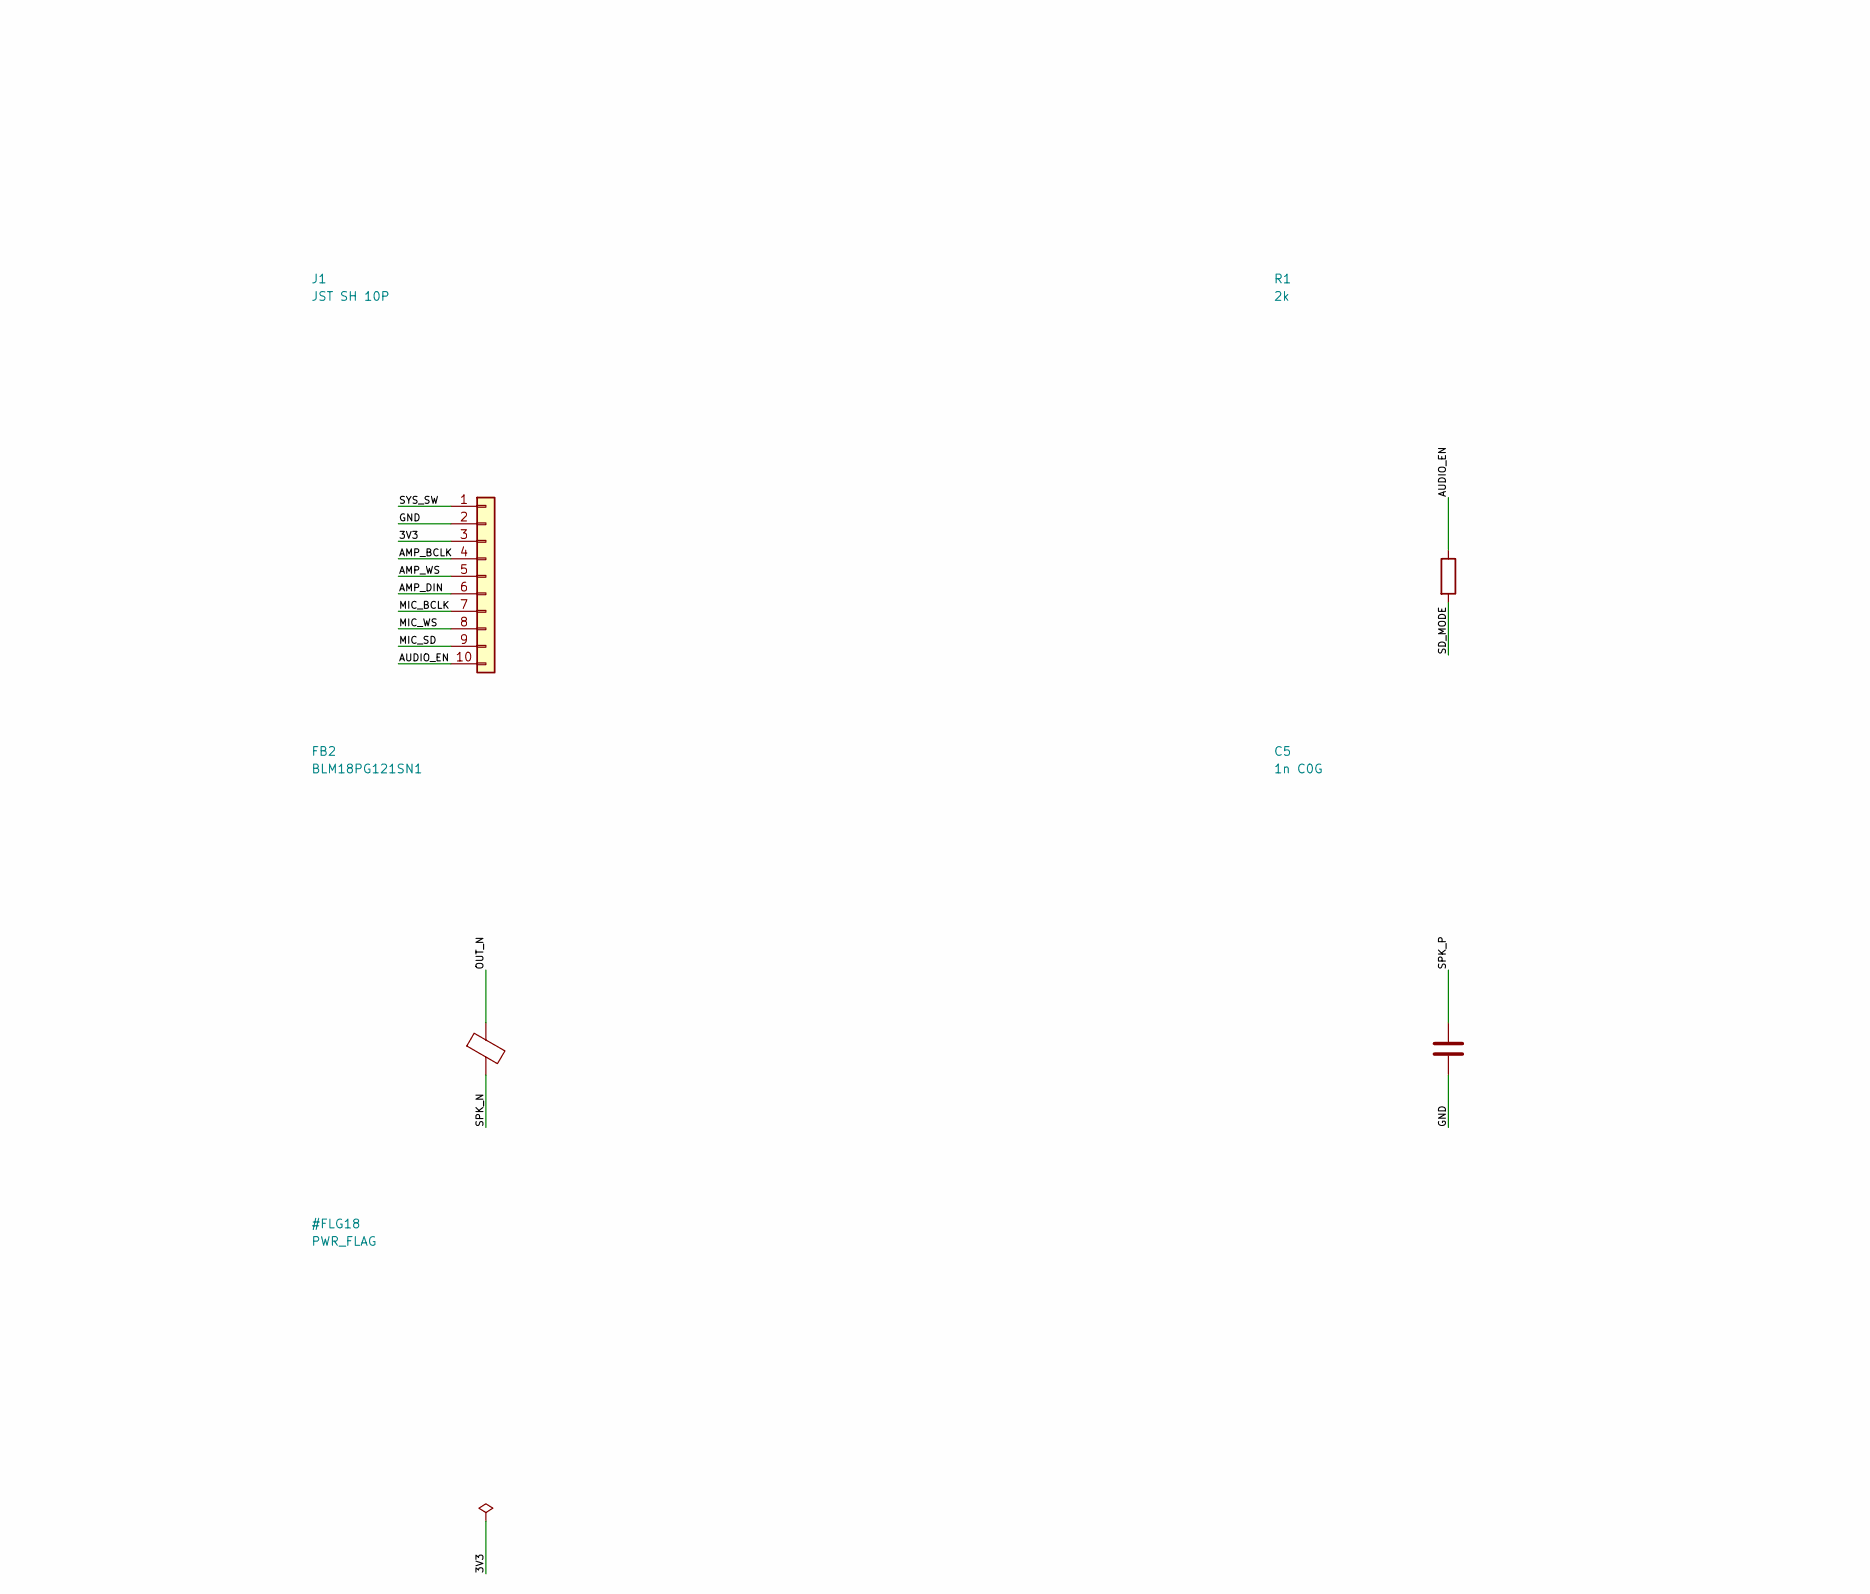
[picture p43: schematic audio_left.kicad_sch, Bone Buds Rev B - audio_left, part in row 1, column 2]

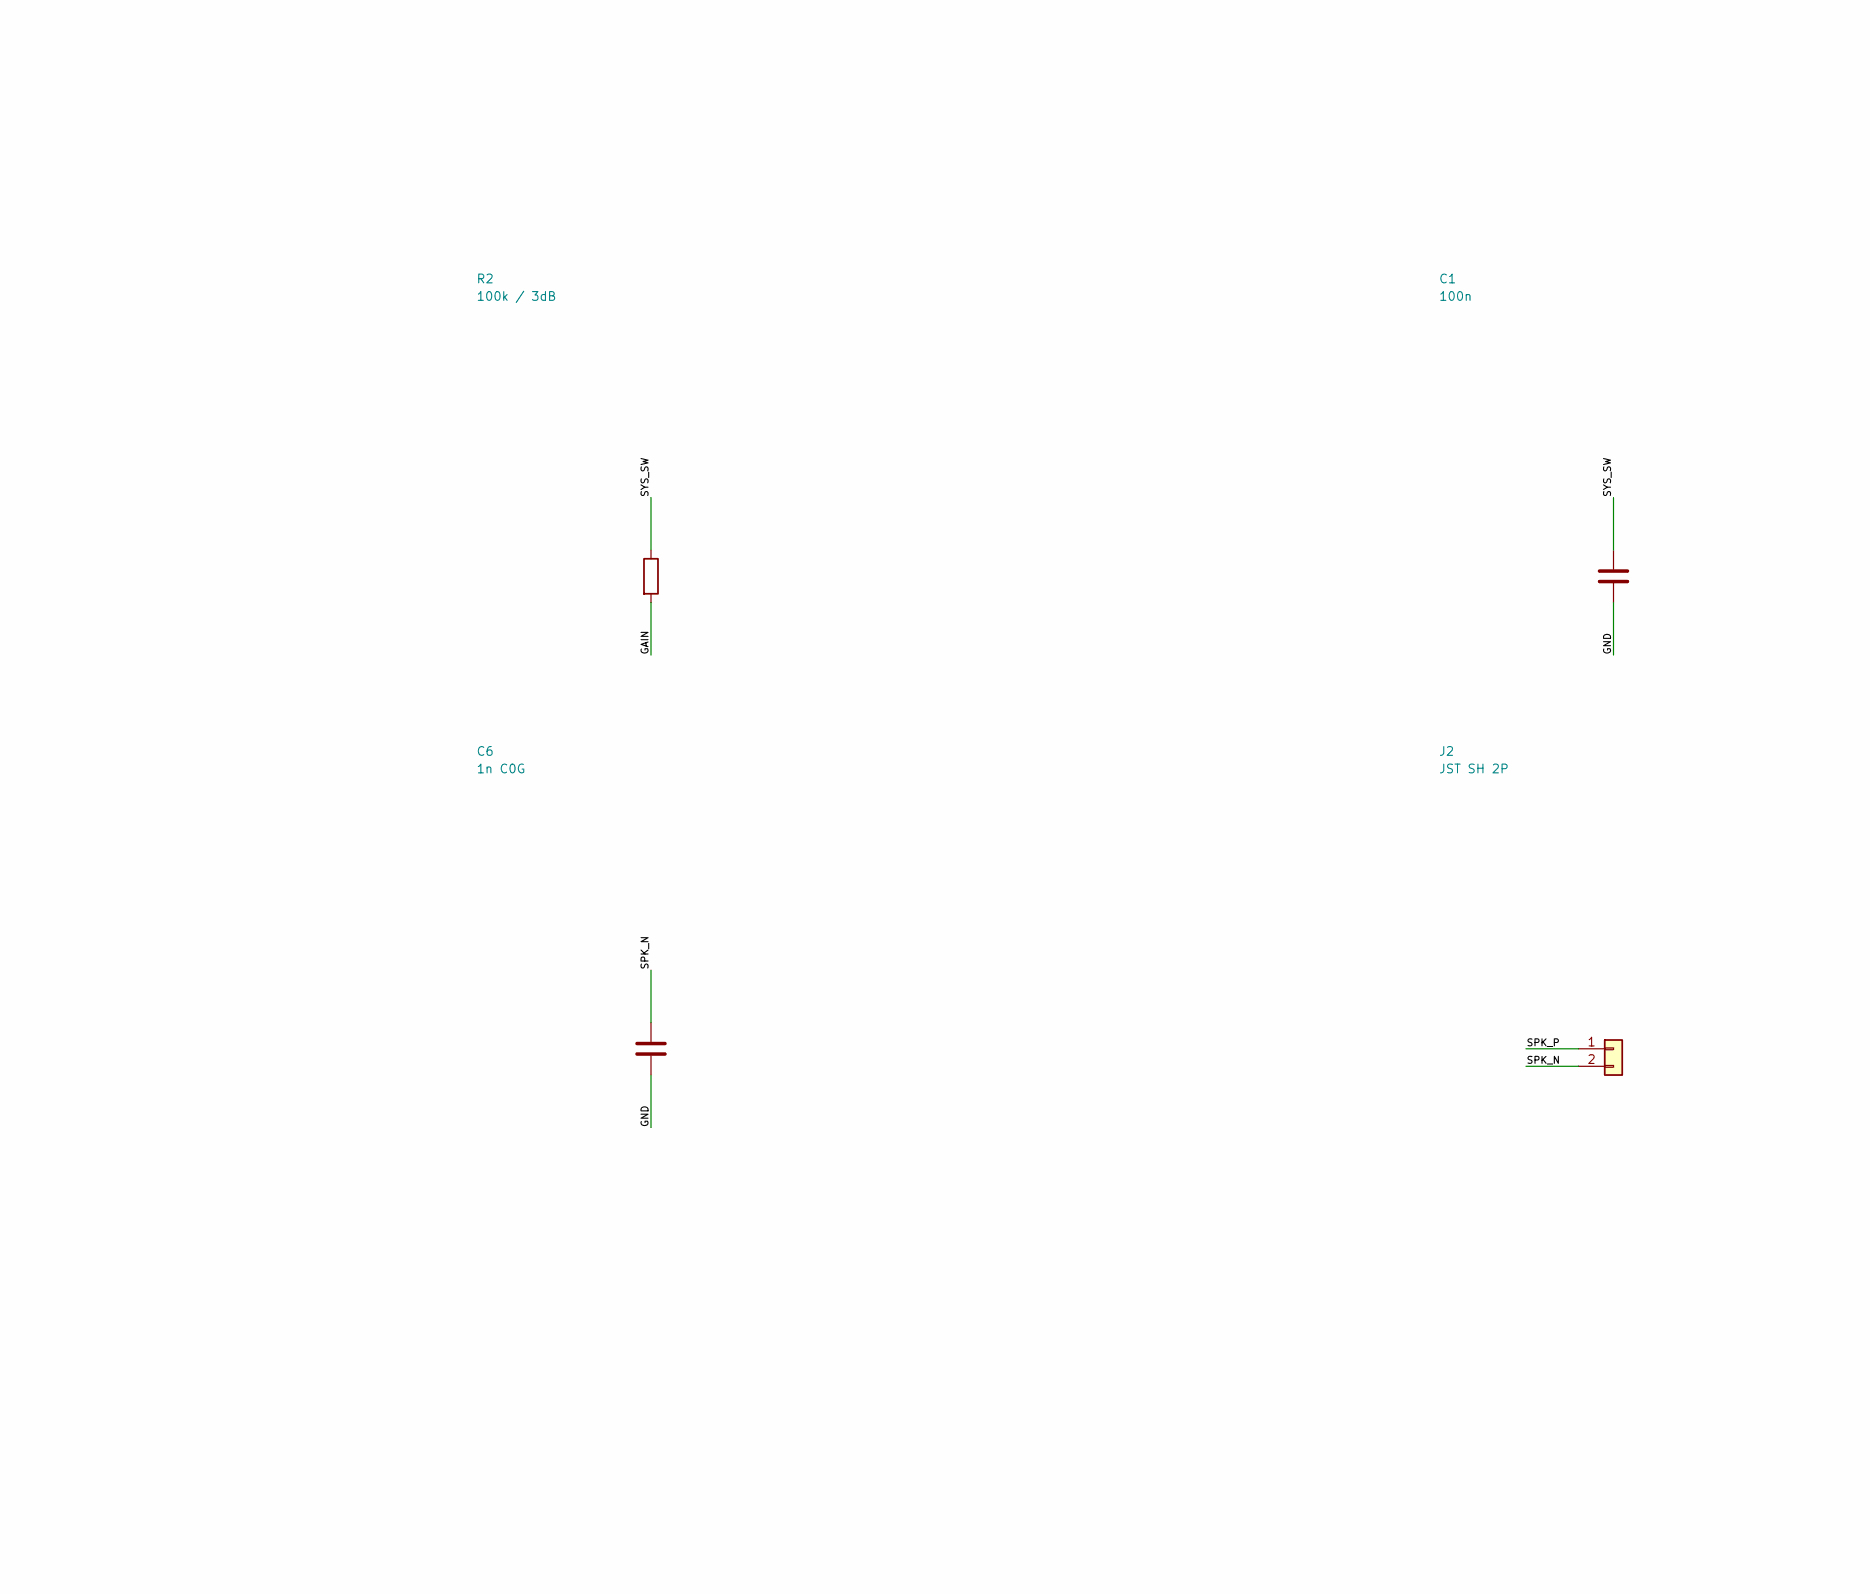
[picture p44: schematic audio_left.kicad_sch, Bone Buds Rev B - audio_left, part in row 1, column 3]

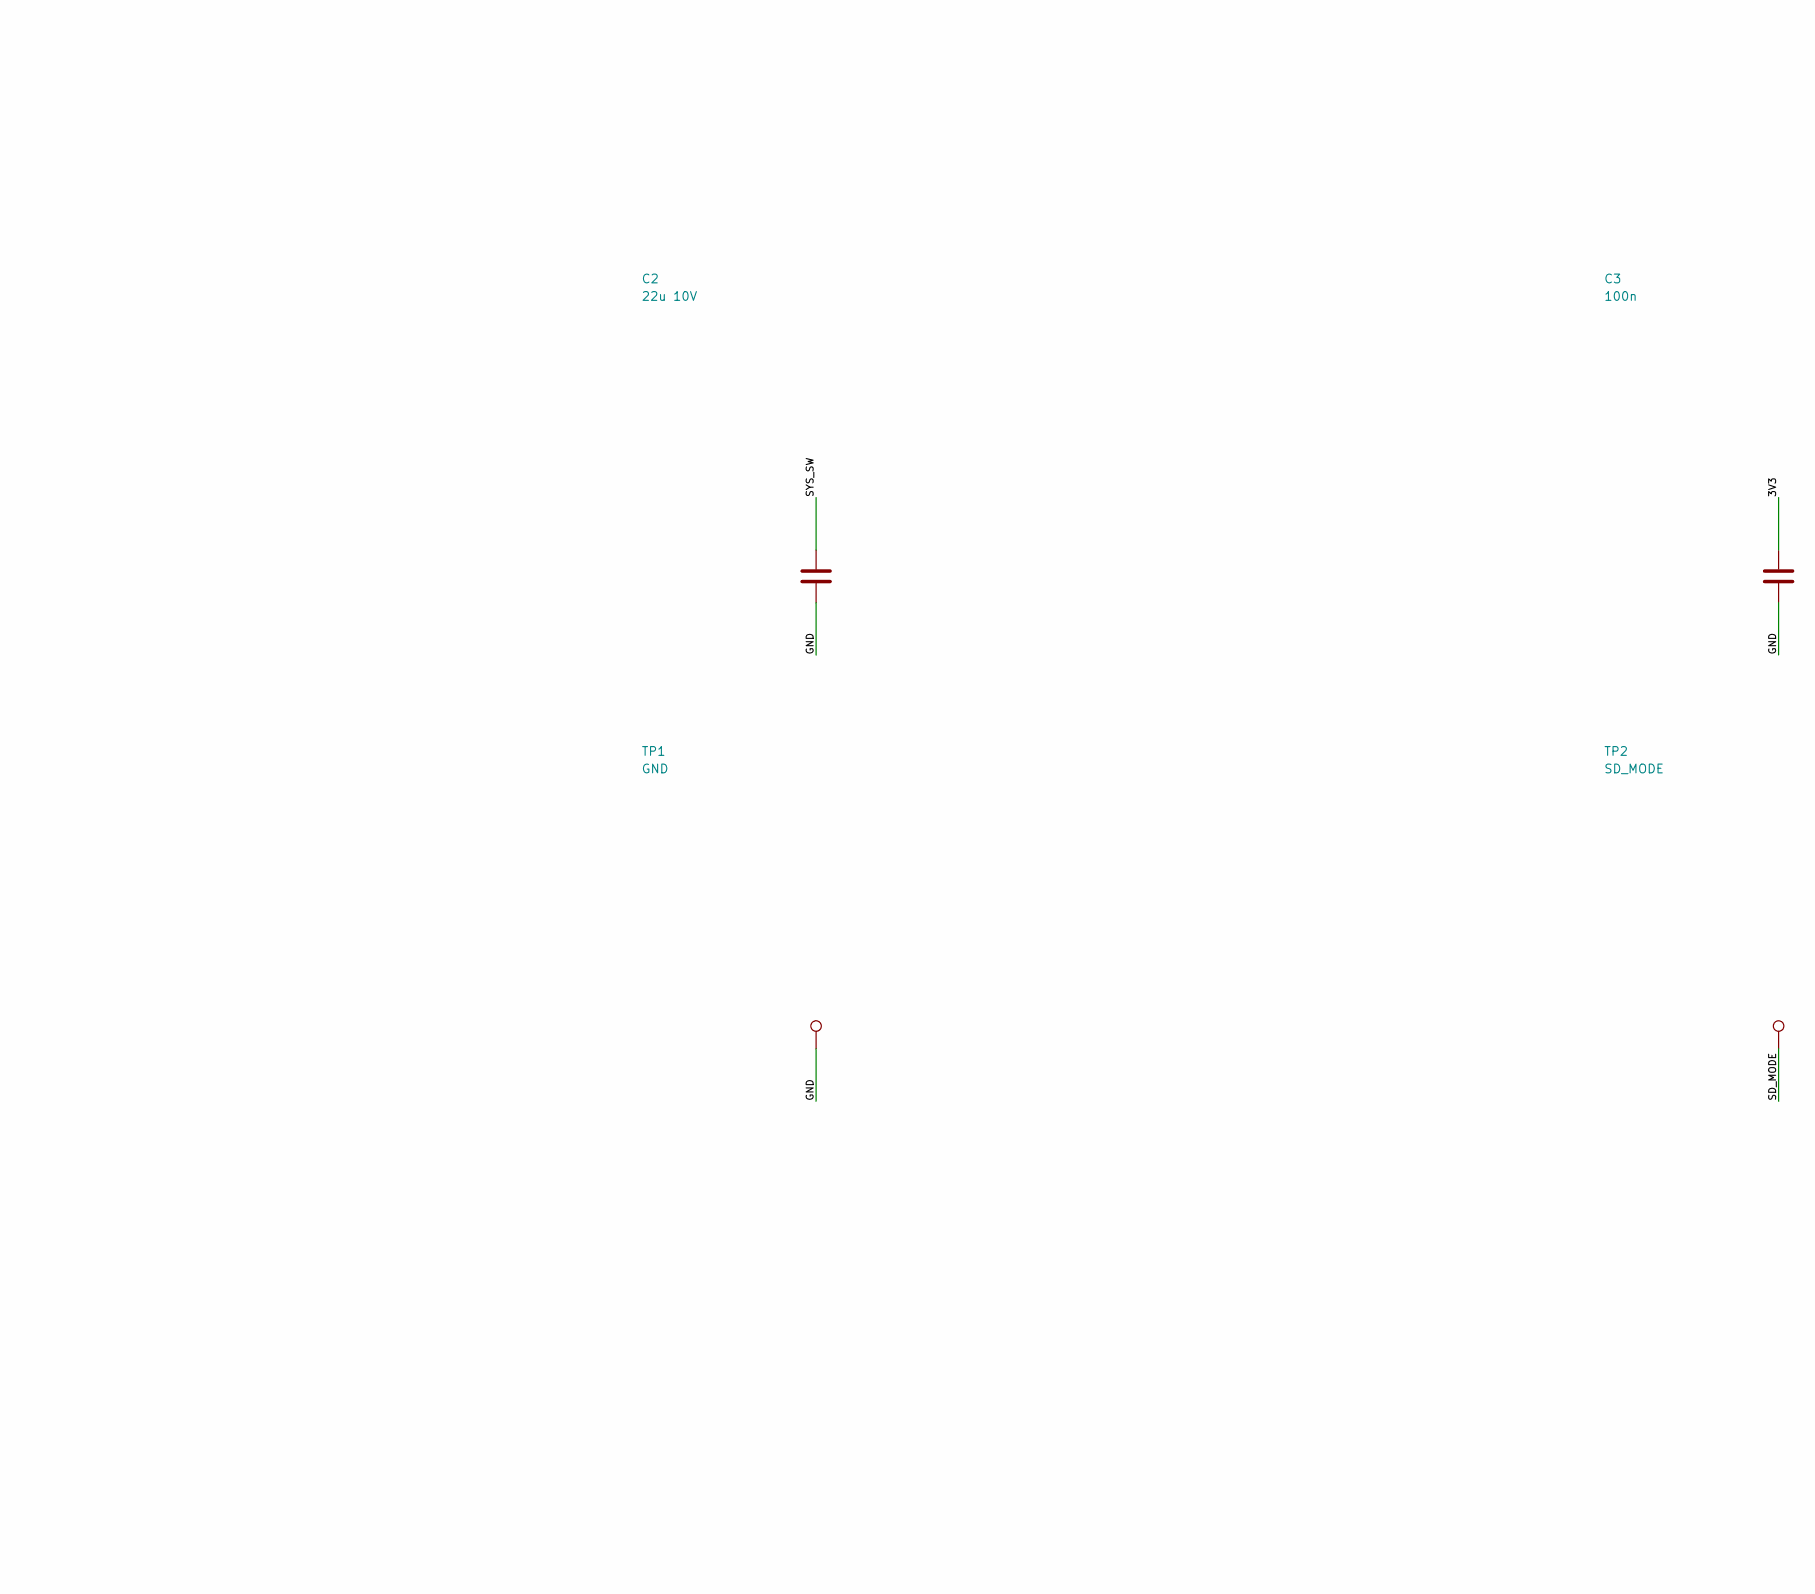
[picture p45: schematic audio_left.kicad_sch, Bone Buds Rev B - audio_left, part in row 1, column 4]

Parts:
C1, C3: 100n; C_0402_1005Metric
C2: 22u 10V; C_0805_2012Metric
C4: 10u; C_0603_1608Metric
C5, C6: 1n C0G; C_0402_1005Metric
FB1, FB2: BLM18PG121SN1; L_0603_1608Metric
J1: JST SH 10P; JST_SH_BM10B-SRSS-TB_1x10-1MP_P1.00mm_Vertical
J2: JST SH 2P; JST_SH_BM02B-SRSS-TB_1x02-1MP_P1.00mm_Vertical
R1: 2k; R_0402_1005Metric
R2: 100k / 3dB; R_0402_1005Metric
TP1: GND; TestPoint_Pad_D1.0mm
TP2: SD_MODE; TestPoint_Pad_D1.0mm
U1: MAX98357A; TQFN-16-1EP_3x3mm_P0.5mm_EP1.23x1.23mm
U2: CMM-4030D-261-I2S-TR; CMM4030

Connections:
/3V3: C3.1, C4.1, J1.3, U2.4 (CHIPEN), U2.8 (VDD)
/AMP_BCLK: J1.4, U1.16 (BCLK)
/AMP_DIN: J1.6, U1.1 (DIN)
/AMP_WS: J1.5, U1.14 (LRCLK)
/AUDIO_EN: J1.10, R1.1
/GAIN: R2.2, U1.2 (GAIN_SLOT)
/GND: C1.2, C2.2, C3.2, C4.2, C5.2, C6.2, J1.2, TP1.1, U1.3 (GND), U1.11 (GND), U1.15 (GND), U1.17 (PAD), U2.1 (GND), U2.5 (LR)
/MIC_BCLK: J1.7, U2.6 (SCK)
/MIC_SD: J1.9, U2.7 (SD)
/MIC_WS: J1.8, U2.3 (WS)
/OUT_N: FB2.1, U1.10 (OUTN)
/OUT_P: FB1.1, U1.9 (OUTP)
/SD_MODE: R1.2, TP2.1, U1.4 (~SD_MODE)
/SPK_N: C6.1, FB2.2, J2.2
/SPK_P: C5.1, FB1.2, J2.1
/SYS_SW: C1.1, C2.1, J1.1, R2.1, U1.7 (VDD), U1.8 (VDD)

Notes on the sheet:
BONE BUDS REV B | AUDIO_LEFT | BARE IC ENGINEERING PROTOTYPE
RF matching, impedance, USB signal integrity, acoustic performance and cell safety require engineering qualification.
Controller requires protected 1S 4.2V LiPo pack + 10k NTC. USB defaults 100mA; firmware may select 500mA ONLY after enumeration.
Audio: 64 clocks per stereo frame. Separate microphone input and amplifier output I2S buses. BTL speaker terminals must never be grounded.

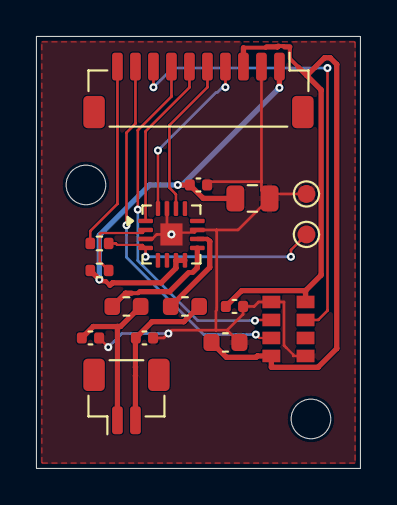
[picture p46: board audio_left.kicad_pcb from above]

Board: 4 copper layers, 18.0 x 24.0 mm, 18 parts (0 on the bottom side), 16 nets.

Other parts of the board:
H1, H2: MountingHole_2.2mm_M2
