aarya-tanwade/bone-buds/hardware/compact_v2/pcb/controller/controller.kicad_pcb

## KiCad design hardware/compact_v2/pcb/controller/controller.kicad_pcb (2026-10-23)

Schematic: controller.kicad_sch, Bone Buds Rev B - controller

Parts:
C1, C6, C7, C8, C9, C10, C21, C24: 100n; C_0402_1005Metric
C2, C5: 1u; C_0402_1005Metric
C3, C4: 12p C0G tune; C_0402_1005Metric
C11: 10u; C_0603_1608Metric
C12: 22u; C_0805_2012Metric
C13, C14: 1.5p RF tune; C_0402_1005Metric
C15, C16: 4.7u 10V; C_0603_1608Metric
C17: 10u 10V; C_0805_2012Metric
C18: 1n; C_0402_1005Metric
C19, C20, C22, C23: 10u; C_0805_2012Metric
D1: BAT54H; D_SOD-323
FB1: BLM18AG601SN1 600R; L_0603_1608Metric
J1: U.FL 2.4GHz antenna; U.FL_Hirose_U.FL-R-SMT-1_Vertical
J2: GCT USB4105-GF-A; USB_C_Receptacle_GCT_USB4105-xx-A_16P_TopMnt_Horizontal
J3: JST SH 3P; JST_SH_BM03B-SRSS-TB_1x03-1MP_P1.00mm_Vertical
J4, J5: JST SH 10P; JST_SH_BM10B-SRSS-TB_1x10-1MP_P1.00mm_Vertical
J6: JST SH 2P; JST_SH_BM02B-SRSS-TB_1x02-1MP_P1.00mm_Vertical
L1: 24nH RF tuning; L_0402_1005Metric
L2: 2.4nH RF tune; L_0402_1005Metric
L3: 1.5uH >=2A DCR<100m; L_Wuerth_MAPI-3015
R1, R14, R15, R16, R17, R18: 33R; R_0402_1005Metric
R2, R3, R21, R22, R23: 10k; R_0402_1005Metric
R4, R11, R19, R20: 100k; R_0402_1005Metric
R5, R6: 5.1k 1%; R_0402_1005Metric
R7, R8: 22R; R_0402_1005Metric
R9: 3.57k 1% 249mA; R_0402_1005Metric
R10: 3.48k 1%; R_0402_1005Metric
R12: 1M; R_0402_1005Metric
R13: 330k; R_0402_1005Metric
R24: 100R; R_0402_1005Metric
SW1: POWER; SW_SPDT_PCM12
SW2: MUTE / PLAY; SW_SPDT_PCM12
TP1: BOOT; TestPoint_Pad_D1.0mm
TP2: CHIP_EN; TestPoint_Pad_D1.0mm
TP3: GND; TestPoint_Pad_D1.0mm
TP4: UART_TX; TestPoint_Pad_D1.0mm
TP5: UART_RX; TestPoint_Pad_D1.0mm
TP6: BAT; TestPoint_Pad_D1.0mm
TP7: SYS; TestPoint_Pad_D1.0mm
TP8: 3V3; TestPoint_Pad_D1.0mm
TP9: CHG; TestPoint_Pad_D1.0mm
TP10: PGOOD; TestPoint_Pad_D1.0mm
U1: ESP32-S3R8; QFN-56-1EP_7x7mm_P0.4mm_EP4x4mm
U2: W25Q128JVPIQ / 16 MB; WSON-8-1EP_6x5mm_P1.27mm_EP3.4x4.3mm
U3: USBLC6-2SC6; SOT-23-6
U4: BQ24074RGT; VQFN-16-1EP_3x3mm_P0.5mm_EP1.6x1.6mm
U5: TPS22917DBV; SOT-23-6
U6: TPS63031DSK; WSON-10-1EP_2.5x2.5mm_P0.5mm_EP1.2x2mm
U7: TPS3839K33DBZR / 3.08V; SOT-23
Y1: 40MHz 10ppm CL8pF; Crystal_SMD_2016-4Pin_2.0x1.6mm

Connections:
/3V3: C7.1, C8.1, C12.1, C22.1, C23.1, FB1.1, J4.3, J5.3, R2.1, R3.1, R21.2, TP8.1, U1.20 (VDD3P3_RTC), U1.46 (VDD3P3_CPU), U6.1 (VOUT), U6.10 (FB), U7.3 (VDD)
/3V3_RF: C6.1, C9.1, C11.1, FB1.2, U1.2 (VDD3P3), U1.3 (VDD3P3), U1.55 (VDDA), U1.56 (VDDA)
/AMP_BCLK: J4.4, J5.4, R14.2
/AMP_BCLK_SRC: R14.1, U1.9 (GPIO4)
/AMP_DIN: J4.6, J5.6, R16.2
/AMP_DIN_SRC: R16.1, U1.11 (GPIO6)
/AMP_WS: J4.5, J5.5, R15.2
/AMP_WS_SRC: R15.1, U1.10 (GPIO5)
/AUDIO_EN: J4.10, J5.10, SW2.2 (B)
/AUDIO_GPIO: R20.1, SW2.1 (A), U1.15 (GPIO10)
/BAT: C16.1, J3.1, R12.1, TP6.1, U4.2 (BAT), U4.3 (BAT)
/BAT_ADC: C24.1, R12.2, R13.1, U1.6 (GPIO1)
/BAT_NTC: J3.3, U4.1 (TS)
/BOOT: R3.2, TP1.1, U1.5 (GPIO0)
/BUCK_L1: L3.1, U6.4 (L1)
/BUCK_L2: L3.2, U6.2 (L2)
/CC1: J2.A5 (CC1), R5.1
/CC2: J2.B5 (CC2), R6.1
/CHG: TP9.1, U4.9 (~CHG)
/CHIP_EN: C5.1, D1.2 (A), R2.2, TP2.1, U1.4 (CHIP_PU)
/CT: C18.1, U5.4 (CT)
/DN_ESD: J2.A7 (D-), J2.B7 (D-), R8.1, U3.3 (I/O2), U3.4 (I/O2)
/DP_ESD: J2.A6 (D+), J2.B6 (D+), R7.1, U3.1 (I/O1), U3.6 (I/O1)
/GND: C1.2, C2.2, C3.2, C4.2, C5.2, C6.2, C7.2, C8.2, C9.2, C10.2, C11.2, C12.2, C13.2, C14.2, C15.2, C16.2, C17.2, C18.2, C19.2, C20.2, C21.2, C22.2, C23.2, C24.2, J1.2 (Ext), J2.A1 (GND), J2.A12 (GND), J2.B1 (GND), J2.B12 (GND), J2.SH (SHIELD), J3.2, J4.2, J5.2, J6.2, R4.2, R5.2, R6.2, R9.2, R10.2, R11.2, R13.2, R19.2, R20.2, R22.2, R23.2, SW1.3 (C), SW2.3 (C), TP3.1, U1.57 (GND), U2.4 (GND), U2.9 (EP), U3.2 (GND), U4.4 (~CE), U4.5 (EN2), U4.8 (VSS), U4.17 (VSS), U5.2 (GND), U6.3 (PGND), U6.9 (GND), U6.11 (PGND), U7.1 (GND), Y1.2 (G), Y1.4 (G)
/ILIM: R10.1, U4.12 (ILIM)
/ISET: R9.1, U4.16 (ISET)
/MIC_BCLK: J4.7, J5.7, R17.2
/MIC_BCLK_SRC: R17.1, U1.12 (GPIO7)
/MIC_SD: J4.9, J5.9, R19.1, U1.14 (GPIO9)
/MIC_WS: J4.8, J5.8, R18.2
/MIC_WS_SRC: R18.1, U1.13 (GPIO8)
/PGOOD: TP10.1, U4.7 (~PGOOD)
/PWR_ON: R11.1, SW1.2 (B), U5.3 (ON)
/QOD: R24.1, U5.5 (QOD)
/RESET_SUP: D1.1 (K), U7.2 (~RESET)
/RF_50: C14.1, J1.1 (In), L2.2
/RF_CHIP: C13.1, L2.1, U1.1 (LNA_IN)
/SPI_CLK: R1.1, U1.33 (SPICLK)
/SPI_CLK_FLASH: R1.2, U2.6 (CLK)
/SPI_CS: U1.32 (SPICS0), U2.1 (~CS)
/SPI_D: U1.35 (SPID), U2.5 (DI/IO_{0})
/SPI_HD: U1.30 (SPIHD), U2.7 (~HOLD/~RESET/IO_{3})
/SPI_Q: U1.34 (SPIQ), U2.2 (DO/IO_{1})
/SPI_WP: U1.31 (SPIWP), U2.3 (~WP/IO_{2})
/STRAP45: R22.1, U1.51 (GPIO45)
/STRAP46: R23.1, U1.52 (GPIO46)
/SYS: C17.1, SW1.1 (A), TP7.1, U4.10 (OUT), U4.11 (OUT), U5.1 (VIN)
/SYS_SW: C19.1, C20.1, C21.1, J4.1, J5.1, R24.2, U5.6 (VOUT), U6.5 (VIN), U6.6 (EN), U6.7 (PS/SYNC), U6.8 (VINA)
/UART_RX: TP5.1, U1.50 (U0RXD)
/UART_TX: TP4.1, U1.49 (U0TXD)
/USB_500_EN: R4.1, U1.16 (GPIO11), U4.6 (EN1)
/USB_DN: R8.2, U1.25 (GPIO19/USB_D-)
/USB_DP: R7.2, U1.26 (GPIO20/USB_D+)
/USER_KEY: J6.1, R21.1, U1.17 (GPIO12)
/VBUS: C15.1, J2.A4 (VBUS), J2.A9 (VBUS), J2.B4 (VBUS), J2.B9 (VBUS), U3.5 (VBUS), U4.13 (IN)
/VDD_SPI: C1.1, C2.1, C10.1, U1.29 (VDD_SPI), U2.8 (VCC)
/XTAL_DRIVE: C3.1, L1.2, Y1.1
/XTAL_N: C4.1, U1.53 (XTAL_N), Y1.3
/XTAL_P: L1.1, U1.54 (XTAL_P)

Notes on the sheet:
BONE BUDS REV B | CONTROLLER | BARE IC ENGINEERING PROTOTYPE
RF matching, impedance, USB signal integrity, acoustic performance and cell safety require engineering qualification.
Controller requires protected 1S 4.2V LiPo pack + 10k NTC. USB defaults 100mA; firmware may select 500mA ONLY after enumeration.
Audio: 64 clocks per stereo frame. Separate microphone input and amplifier output I2S buses. BTL speaker terminals must never be grounded.

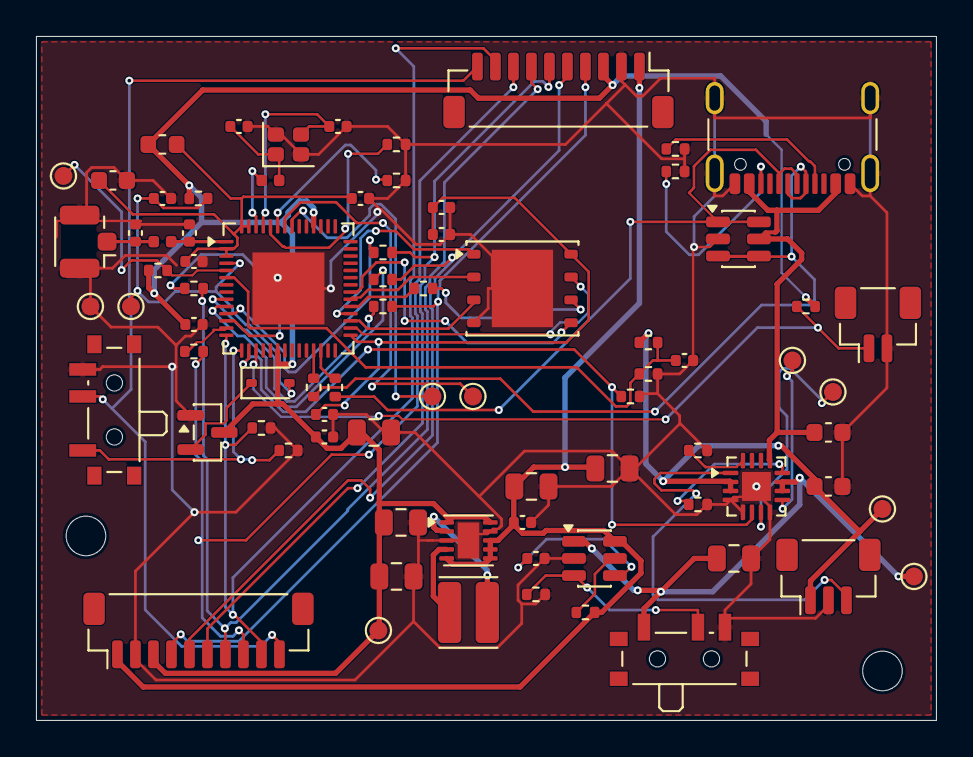
[picture p47: board controller.kicad_pcb from above]

Board: 4 copper layers, 50.0 x 38.0 mm, 81 parts (0 on the bottom side), 59 nets.

Other parts of the board:
H1, H2: MountingHole_2.2mm_M2
