aarya-tanwade/bone-buds/(commit log)

2026-10-18 Add prototype 1 firmware
2026-10-20 docs: organize prototype, hardware, and development notes
2026-10-29 docs: rename firmware index to OSSIS and track OTA experiment
